downbeat/senseye/hardware/v2/stonyman_adc_board/schematic_and_layout_pdf/README

The source files for imager-adc.pdf (in the src directory) must be created
manually by printing to a PDF file from within the EAGLE tool.  The Makefile
merely uses PDFjam to combine those PDF files into a single documents.
