downbeat/senseye/software/v2/embedded/smartfusion_libero/senseye/designer/impl1/TOPLEVEL_iobank_report.txt

********************************************************************
                            I/O Bank Report
********************************************************************
  
Product: Designer
Release: v10.1 SP3
Version: 10.1.3.1
Date: Tue Oct 22 18:05:42 2013
Design Name: TOPLEVEL  Family: SmartFusion  Die: A2F500M3G  Package: 484 FBGA

I/O Function:

    Type                          | w/o register  | w/ register  | w/ DDR register
    ------------------------------|---------------|--------------|----------------
    Input I/O                     | 3             | 0            | 0
    Output I/O                    | 56            | 0            | 0
    Bidirectional I/O             | 16            | 0            | 0
    Differential Input I/O Pairs  | 0             | 0            | 0
    Differential Output I/O Pairs | 0             | 0            | 0

I/O Technology:

                                    |   Voltages    |             I/Os
    --------------------------------|-------|-------|-------|--------|--------------
    I/O Standard(s)                 | Vcci  | Vref  | Input | Output | Bidirectional
    --------------------------------|-------|-------|-------|--------|--------------
    LVTTL                           | 3.30v | N/A   | 3     | 56     | 16

I/O Bank Resource Usage:

          |   Voltages    | Single I/Os  | Diff I/O Pairs |        Vref I/Os
          |-------|-------|------|-------|-------|--------|------|-------|----------
          | Vcci  | Vref  | Used | Total | Used  | Total  | Used | Total | Vref Pins
    ------|-------|-------|------|-------|-------|--------|------|-------|----------
    Bank0 | 3.30v | N/A   | 32   | 50    | 0     | 25     | N/A  | N/A   | N/A
    Bank1 | 3.30v | N/A   | 10   | 36    | 0     | 18     | N/A  | N/A   | N/A
    Bank2 | MSS   | N/A   | N/A  | N/A   | N/A   | N/A    | N/A  | N/A   | N/A
    Bank3 | ANALOG| N/A   | N/A  | N/A   | N/A   | N/A    | N/A  | N/A   | N/A
    Bank4 | MSS   | N/A   | N/A  | N/A   | N/A   | N/A    | N/A  | N/A   | N/A
    Bank5 | 3.30v | N/A   | 33   | 42    | 0     | 21     | N/A  | N/A   | N/A

I/O Voltage Usage:

       Voltages    |     I/Os
    -------|-------|------|-------
     Vcci  | Vref  | Used | Total
    -------|-------|------|-------
     3.30v | N/A   | 75   | 128
