downbeat/senseye/software/v2/embedded/smartfusion_libero/senseye/designer/impl1/TOPLEVEL_maxdelay_timingviolations_report.txt

Timing Violation Report Max Delay Analysis

SmartTime Version v10.1 SP3
Actel Corporation - Actel Designer Software Release v10.1 SP3 (Version 10.1.3.1)
Copyright (c) 1989-2013
Date: Tue Oct 22 18:05:55 2013

Design: TOPLEVEL
Family: SmartFusion
Die: A2F500M3G
Package: 484 FBGA
Temperature: -40 25 100
Voltage: COM
Speed Grade: STD
Design State: Post-Layout
Data source: Silicon verified
Min Operating Condition: BEST
Max Operating Condition: WORST
Using Enhanced Min Delay Analysis
Scenario for Timing Analysis: Primary

No Path
