downbeat/senseye/hardware/v2/stonyman_adc_board/wirebonding_document/centeye/stonyman-die.png

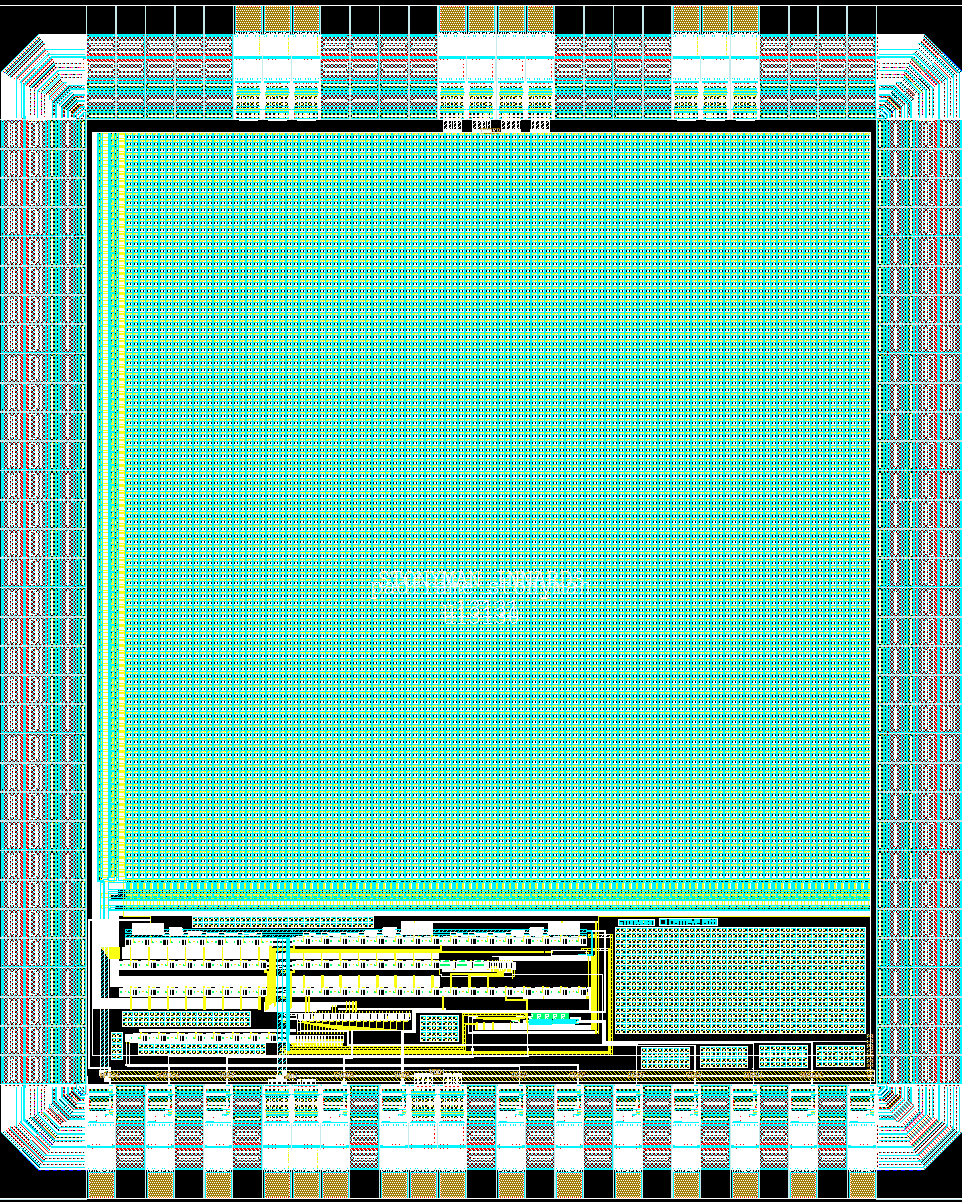
hardware/v2/stonyman_adc_board/wirebonding_document/centeye/stonyman-die.png
