downbeat/senseye/hardware/v2/stonyman_adc_board/wirebonding_document/src/senseye-imager-adc.png

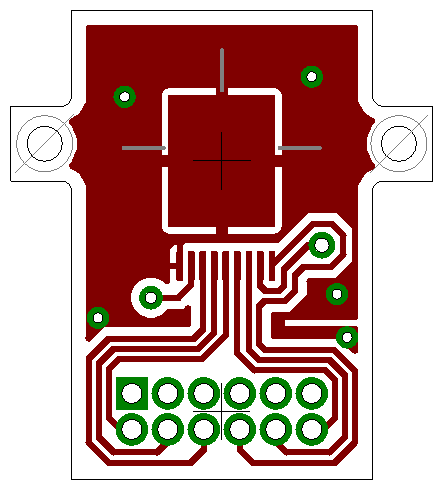
hardware/v2/stonyman_adc_board/wirebonding_document/src/senseye-imager-adc.png
