downbeat/senseye/hardware/v2/stonyman_adc_board/eagle_pcb/imager-adc_bom.xlsx

Part | Value | Package | DIGIKEY | Description
C1 | 1nF | C0603 | 1276-1916-2-ND | CAPACITOR, European symbol
C2 | 0.1uF | C0603 | 1276-1012-2-ND | CAPACITOR, European symbol
C3 | 0.1uF | C0603 | 1276-1012-2-ND | CAPACITOR, European symbol
C4 | 1uF | C0603 | 1276-1243-2-ND | CAPACITOR, European symbol
C5 | OPTIONAL: 10pF-1nF | C0603 | 1276-1187-6-ND | CAPACITOR, European symbol
J1 | HEADER_12PIN2X6_NOSILK | HEADER2X6/0.05IN_NO_SILK | S9015E-06-ND
R1 | 0 / UNPOP | R0603 | 1276-3510-6-ND | RESISTOR, American symbol
U1 | STONYMANDEFAULT_LENS_MOUNT | STONYMAN_DEFAULT_LENS |  | Centeye Stonyman imager chip
U2 | TI_ADCXX1S101 | SOT23-6 | ADC121S101CIMF/NOPBDKR-ND | Texas Instruments ADCXX1S101 (ADC081S101, ADC101S101, ADC121S101) Single Channel, 0.5 to 1.0 Msps, 8-bit, 10-bit and 12-bit A/D Converters
