downbeat/senseye/hardware/v1/teensy-shield/main.dxf

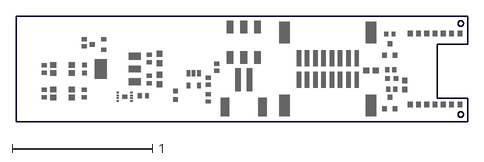
[picture p4: CAD file, 2012-11-15, an earlier design]
hardware/v1/teensy-shield/main.dxf
3.23 x 0.75
