downbeat/senseye/(list of files, cad)

Other CAD files:
software/v2/embedded/smartfusion_libero/senseye/component/Actel/DirectCore/CoreAHBLite/3.1.102/mti/user_vlog/COREAHBLITE_LIB/@b@f@m_@a@h@b@l/verilog.psm
software/v2/embedded/smartfusion_libero/senseye/component/Actel/DirectCore/CoreAHBLite/3.1.102/mti/user_vlog/COREAHBLITE_LIB/@b@f@m_@a@h@b@s@l@a@v@e/verilog.psm
software/v2/embedded/smartfusion_libero/senseye/component/Actel/DirectCore/CoreAHBLite/3.1.102/mti/user_vlog/COREAHBLITE_LIB/@b@f@m_@a@h@b@s@l@a@v@e@e@x@t/verilog.psm
software/v2/embedded/smartfusion_libero/senseye/component/Actel/DirectCore/CoreAHBLite/3.1.102/mti/user_vlog/COREAHBLITE_LIB/@b@f@m_@m@a@i@n/verilog.psm
software/v2/embedded/smartfusion_libero/senseye/component/Actel/DirectCore/CoreAPB3/3.0.103/mti/user_vlog/COREAPB3_LIB/@b@f@m@a1l1@o@i@i/verilog.psm
software/v2/embedded/smartfusion_libero/senseye/component/Actel/DirectCore/CoreAPB3/3.0.103/mti/user_vlog/COREAPB3_LIB/@b@f@m_@a@p@b/verilog.psm
software/v2/embedded/smartfusion_libero/senseye/component/Actel/DirectCore/CoreAPB3/3.0.103/mti/user_vlog/COREAPB3_LIB/@b@f@m_@a@p@b@s@l@a@v@e/verilog.psm
software/v2/embedded/smartfusion_libero/senseye/component/Actel/DirectCore/CoreAPB3/3.0.103/mti/user_vlog/COREAPB3_LIB/@b@f@m_@a@p@b@s@l@a@v@e@e@x@t/verilog.psm
software/v2/embedded/smartfusion_libero/senseye/component/Actel/DirectCore/CoreAPB3/3.0.103/mti/user_vlog/COREAPB3_LIB/@b@f@m_@m@a@i@n/verilog.psm
software/v2/embedded/smartfusion_libero/senseye/component/Actel/SmartFusionMSS/MSS/2.2.101/mti/user_verilog/MSS_BFM_LIB/@addr@dec@m0/verilog.psm
software/v2/embedded/smartfusion_libero/senseye/component/Actel/SmartFusionMSS/MSS/2.2.101/mti/user_verilog/MSS_BFM_LIB/@addr@dec@m1/verilog.psm
software/v2/embedded/smartfusion_libero/senseye/component/Actel/SmartFusionMSS/MSS/2.2.101/mti/user_verilog/MSS_BFM_LIB/@addr@dec@m2/verilog.psm
software/v2/embedded/smartfusion_libero/senseye/component/Actel/SmartFusionMSS/MSS/2.2.101/mti/user_verilog/MSS_BFM_LIB/@addr@dec@m3/verilog.psm
software/v2/embedded/smartfusion_libero/senseye/component/Actel/SmartFusionMSS/MSS/2.2.101/mti/user_verilog/MSS_BFM_LIB/@addr@dec@m4/verilog.psm
software/v2/embedded/smartfusion_libero/senseye/component/Actel/SmartFusionMSS/MSS/2.2.101/mti/user_verilog/MSS_BFM_LIB/@ahb@client_@h@m/verilog.psm
software/v2/embedded/smartfusion_libero/senseye/component/Actel/SmartFusionMSS/MSS/2.2.101/mti/user_verilog/MSS_BFM_LIB/@ahb@wrapper_@f@m/verilog.psm
software/v2/embedded/smartfusion_libero/senseye/component/Actel/SmartFusionMSS/MSS/2.2.101/mti/user_verilog/MSS_BFM_LIB/@ahb@wrapper_@h@m/verilog.psm
software/v2/embedded/smartfusion_libero/senseye/component/Actel/SmartFusionMSS/MSS/2.2.101/mti/user_verilog/MSS_BFM_LIB/@apb@client_@h@m/verilog.psm
software/v2/embedded/smartfusion_libero/senseye/component/Actel/SmartFusionMSS/MSS/2.2.101/mti/user_verilog/MSS_BFM_LIB/@apb@wrapper_@f@m/verilog.psm
software/v2/embedded/smartfusion_libero/senseye/component/Actel/SmartFusionMSS/MSS/2.2.101/mti/user_verilog/MSS_BFM_LIB/@b@f@m_@m@a@i@n/verilog.psm
software/v2/embedded/smartfusion_libero/senseye/component/Actel/SmartFusionMSS/MSS/2.2.101/mti/user_verilog/MSS_BFM_LIB/@c@m@master0@stage/verilog.psm
software/v2/embedded/smartfusion_libero/senseye/component/Actel/SmartFusionMSS/MSS/2.2.101/mti/user_verilog/MSS_BFM_LIB/@c@m@master1@stage/verilog.psm
software/v2/embedded/smartfusion_libero/senseye/component/Actel/SmartFusionMSS/MSS/2.2.101/mti/user_verilog/MSS_BFM_LIB/@c@m@master2@stage/verilog.psm
software/v2/embedded/smartfusion_libero/senseye/component/Actel/SmartFusionMSS/MSS/2.2.101/mti/user_verilog/MSS_BFM_LIB/@c@m@master3@stage/verilog.psm
software/v2/embedded/smartfusion_libero/senseye/component/Actel/SmartFusionMSS/MSS/2.2.101/mti/user_verilog/MSS_BFM_LIB/@c@m@master4@stage/verilog.psm
software/v2/embedded/smartfusion_libero/senseye/component/Actel/SmartFusionMSS/MSS/2.2.101/mti/user_verilog/MSS_BFM_LIB/@c@m@slave@stage/verilog.psm
software/v2/embedded/smartfusion_libero/senseye/component/Actel/SmartFusionMSS/MSS/2.2.101/mti/user_verilog/MSS_BFM_LIB/@client@addr@data_@f@m/verilog.psm
software/v2/embedded/smartfusion_libero/senseye/component/Actel/SmartFusionMSS/MSS/2.2.101/mti/user_verilog/MSS_BFM_LIB/@client@addr@data_@h@m/verilog.psm
software/v2/embedded/smartfusion_libero/senseye/component/Actel/SmartFusionMSS/MSS/2.2.101/mti/user_verilog/MSS_BFM_LIB/@client_@f@m/verilog.psm
software/v2/embedded/smartfusion_libero/senseye/component/Actel/SmartFusionMSS/MSS/2.2.101/mti/user_verilog/MSS_BFM_LIB/@d@s@s@a@b/verilog.psm
software/v2/embedded/smartfusion_libero/senseye/component/Actel/SmartFusionMSS/MSS/2.2.101/mti/user_verilog/MSS_BFM_LIB/@default@slave@s@m/verilog.psm
software/v2/embedded/smartfusion_libero/senseye/component/Actel/SmartFusionMSS/MSS/2.2.101/mti/user_verilog/MSS_BFM_LIB/@f2@a@b/verilog.psm
software/v2/embedded/smartfusion_libero/senseye/component/Actel/SmartFusionMSS/MSS/2.2.101/mti/user_verilog/MSS_BFM_LIB/@f2@d@s@s_@a@c@e/verilog.psm
software/v2/embedded/smartfusion_libero/senseye/component/Actel/SmartFusionMSS/MSS/2.2.101/mti/user_verilog/MSS_BFM_LIB/@f2@d@s@s_@a@c@e_@m@i@s@c/verilog.psm
software/v2/embedded/smartfusion_libero/senseye/component/Actel/SmartFusionMSS/MSS/2.2.101/mti/user_verilog/MSS_BFM_LIB/@f2@d@s@s_@a@c@e_@m@i@s@c_@a@p@b3/verilog.psm
software/v2/embedded/smartfusion_libero/senseye/component/Actel/SmartFusionMSS/MSS/2.2.101/mti/user_verilog/MSS_BFM_LIB/@f2@d@s@s_@a@c@e_@m@i@s@c_@f@d@e@t/verilog.psm
software/v2/embedded/smartfusion_libero/senseye/component/Actel/SmartFusionMSS/MSS/2.2.101/mti/user_verilog/MSS_BFM_LIB/@f2@d@s@s_@a@c@e_@m@i@s@c_@f@d@e@t12/verilog.psm
software/v2/embedded/smartfusion_libero/senseye/component/Actel/SmartFusionMSS/MSS/2.2.101/mti/user_verilog/MSS_BFM_LIB/@f2@d@s@s_@a@c@e_@m@i@s@c_@i@n@t_@l@o@g@i@c/verilog.psm
software/v2/embedded/smartfusion_libero/senseye/component/Actel/SmartFusionMSS/MSS/2.2.101/mti/user_verilog/MSS_BFM_LIB/@f2@d@s@s_@a@c@e_@m@i@s@c_@p@d@m@a/verilog.psm
software/v2/embedded/smartfusion_libero/senseye/component/Actel/SmartFusionMSS/MSS/2.2.101/mti/user_verilog/MSS_BFM_LIB/@f2@d@s@s_@a@c@e_@m@i@s@c_@r@d@e@t/verilog.psm
software/v2/embedded/smartfusion_libero/senseye/component/Actel/SmartFusionMSS/MSS/2.2.101/mti/user_verilog/MSS_BFM_LIB/@f2@d@s@s_@a@c@e_@m@i@s@c_@r@d@e@t12/verilog.psm
software/v2/embedded/smartfusion_libero/senseye/component/Actel/SmartFusionMSS/MSS/2.2.101/mti/user_verilog/MSS_BFM_LIB/@f2@d@s@s_@a@c@e_@m@i@s@c_@r@d@e@t32/verilog.psm
software/v2/embedded/smartfusion_libero/senseye/component/Actel/SmartFusionMSS/MSS/2.2.101/mti/user_verilog/MSS_BFM_LIB/@f2@d@s@s_@a@c@e_@m@i@s@c_@r@d@m@u@x/verilog.psm
software/v2/embedded/smartfusion_libero/senseye/component/Actel/SmartFusionMSS/MSS/2.2.101/mti/user_verilog/MSS_BFM_LIB/@f2@d@s@s_@a@c@e_@m@i@s@c_@s@t@i@c@k@y@f@l@a@g/verilog.psm
software/v2/embedded/smartfusion_libero/senseye/component/Actel/SmartFusionMSS/MSS/2.2.101/mti/user_verilog/MSS_BFM_LIB/@f2@d@s@s_@a@c@e_@m@i@s@c_@s@t@i@c@k@y@f@l@a@g21/verilog.psm
software/v2/embedded/smartfusion_libero/senseye/component/Actel/SmartFusionMSS/MSS/2.2.101/mti/user_verilog/MSS_BFM_LIB/@f2@d@s@s_@a@c@e_@m@i@s@c_@s@t@i@c@k@y@f@l@a@g24/verilog.psm
software/v2/embedded/smartfusion_libero/senseye/component/Actel/SmartFusionMSS/MSS/2.2.101/mti/user_verilog/MSS_BFM_LIB/@f2@d@s@s_@a@c@e_@m@i@s@c_@s@t@i@c@k@y@f@l@a@g32/verilog.psm
software/v2/embedded/smartfusion_libero/senseye/component/Actel/SmartFusionMSS/MSS/2.2.101/mti/user_verilog/MSS_BFM_LIB/@f2@d@s@s_@a@c@e_@m@i@s@c_@s@t@i@c@k@y@f@l@a@g9/verilog.psm
software/v2/embedded/smartfusion_libero/senseye/component/Actel/SmartFusionMSS/MSS/2.2.101/mti/user_verilog/MSS_BFM_LIB/@f2@d@s@s_@a@c@e_@m@i@s@c_@s@y@n@c/verilog.psm
software/v2/embedded/smartfusion_libero/senseye/component/Actel/SmartFusionMSS/MSS/2.2.101/mti/user_verilog/MSS_BFM_LIB/@f2@d@s@s_@a@c@e_@m@i@s@c_@s@y@n@c12/verilog.psm
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
