downbeat/senseye/hardware/v2/stonyman_adc_board/schematic_and_layout_pdf/imager-adc.pdf

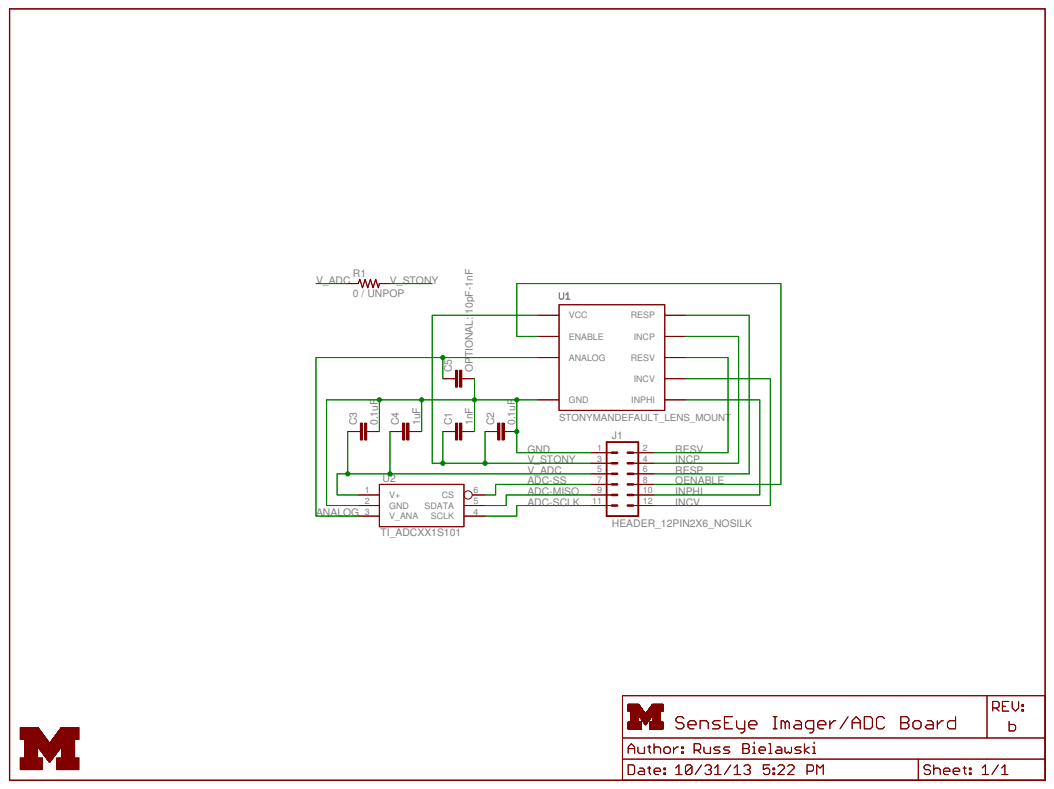
[picture p7: page 1]

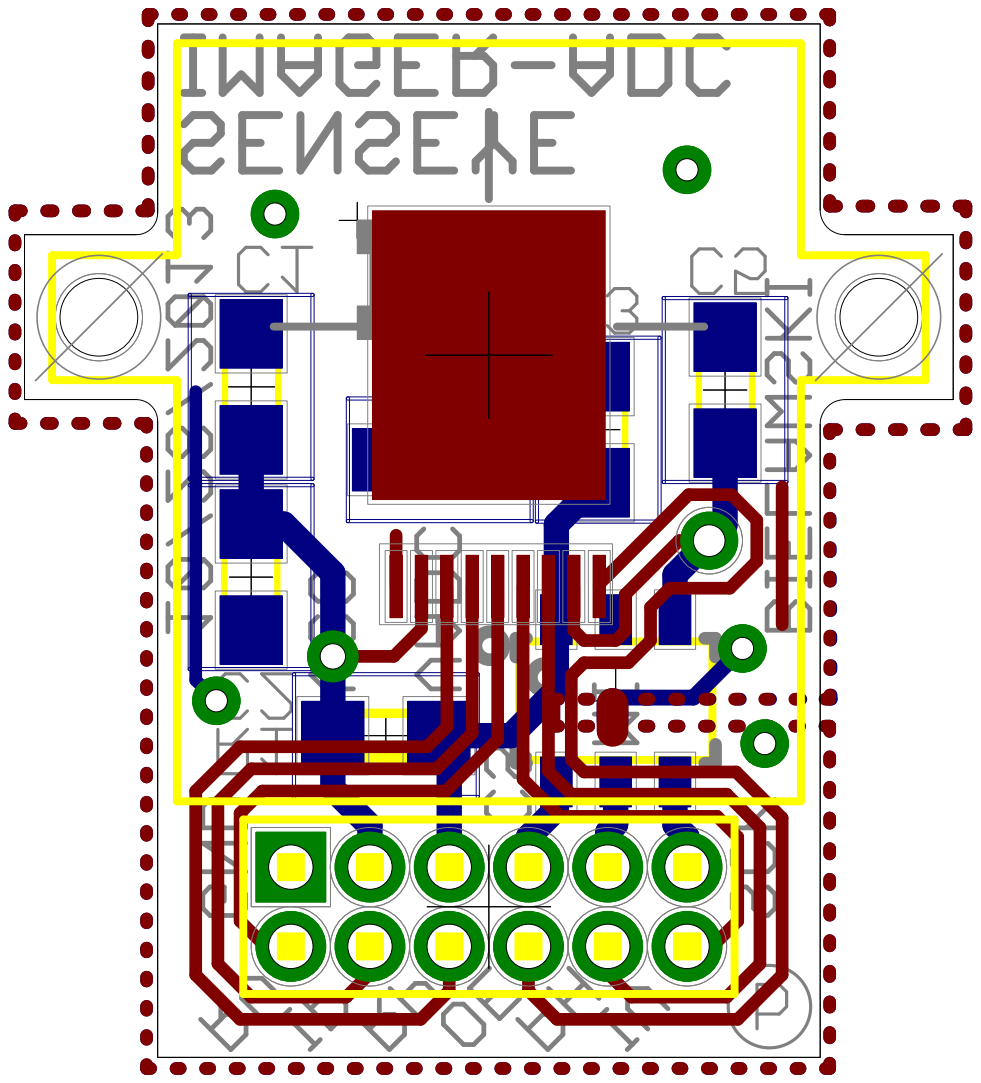
[picture p8: page 2]

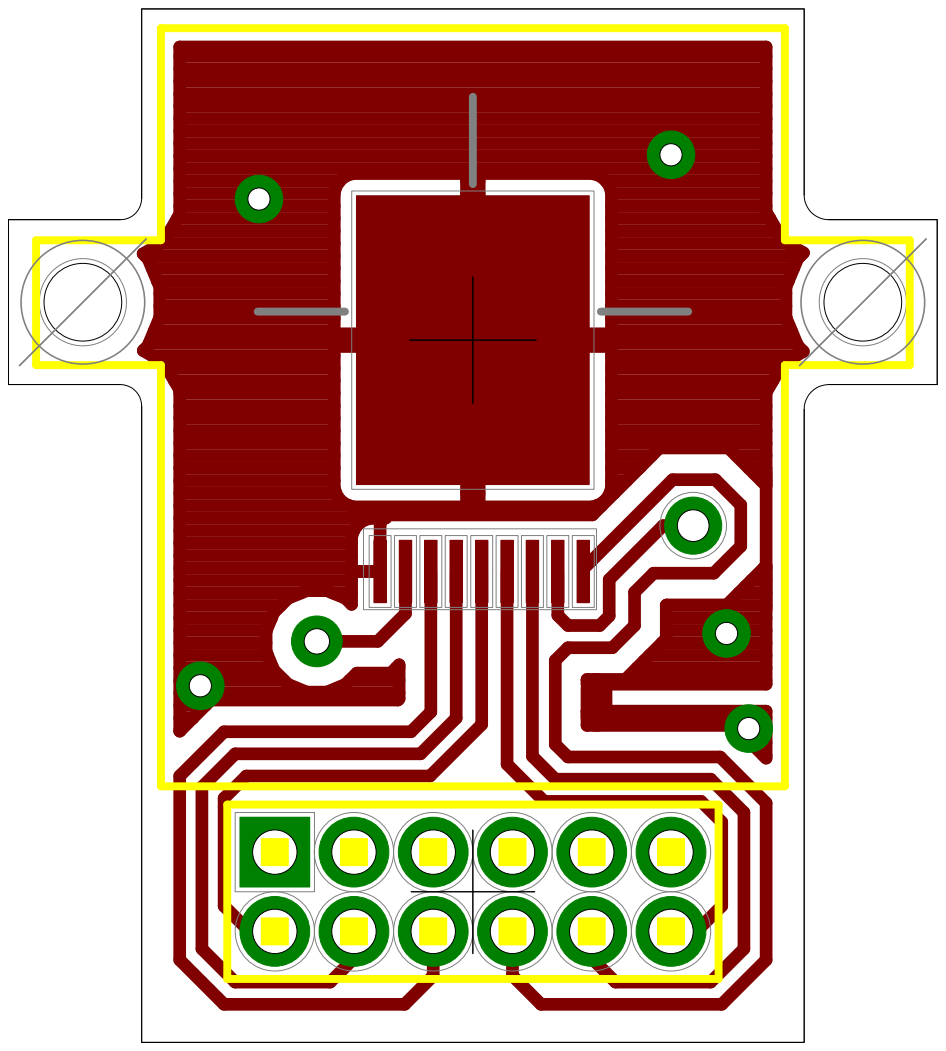
[picture p9: page 3]

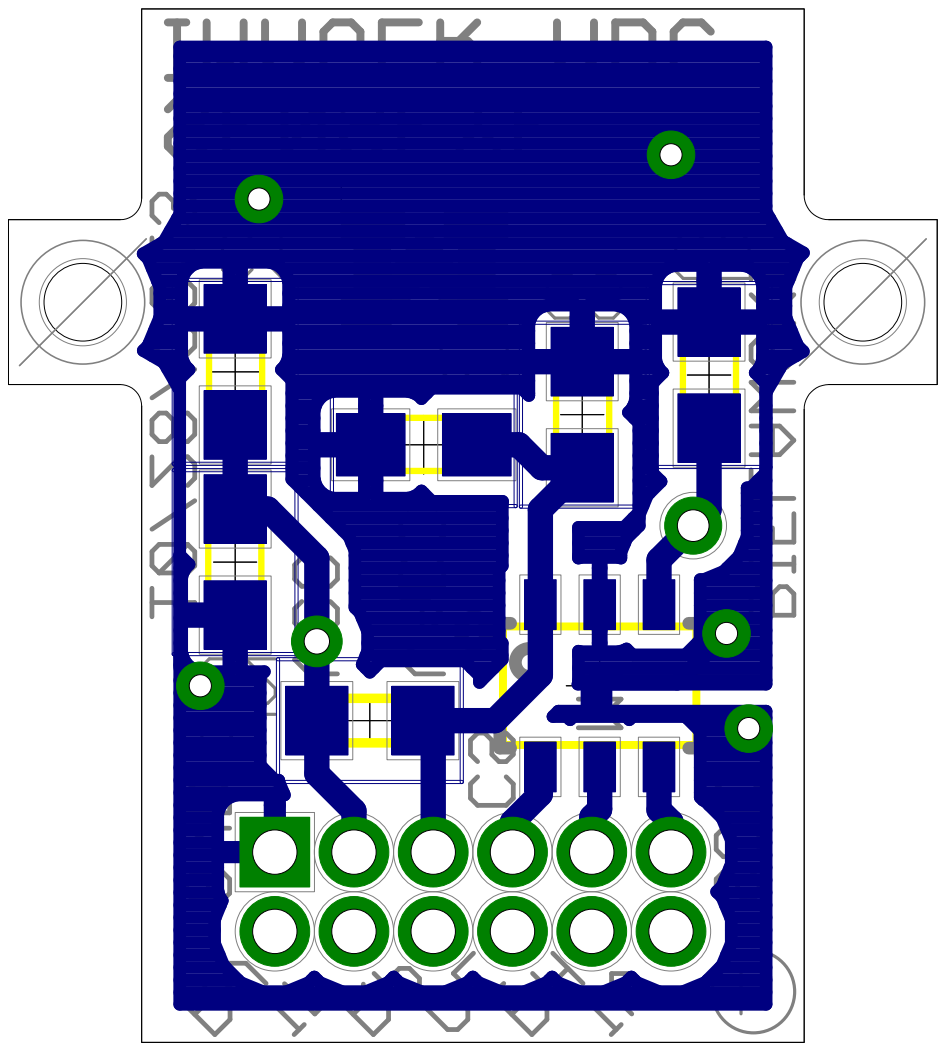
[picture p10: page 4]

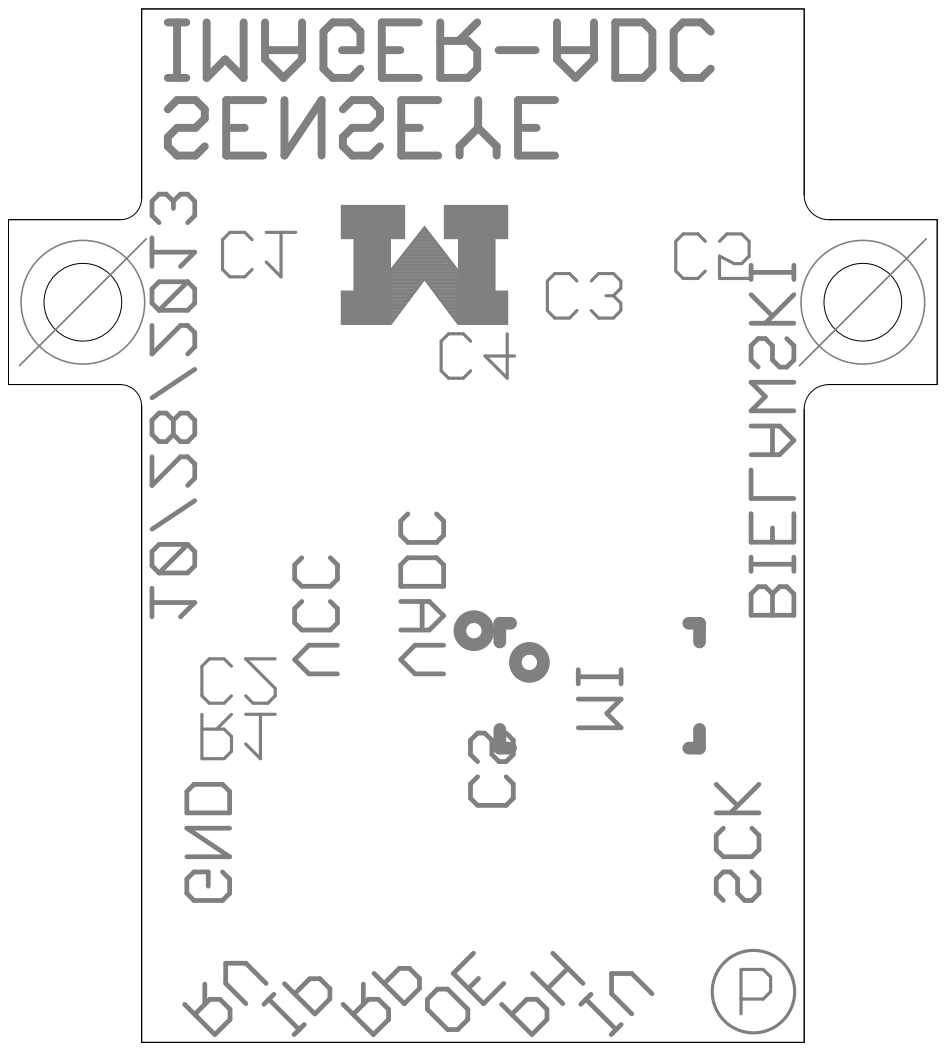
[picture p11: page 5]
