downbeat/senseye/hardware/v2/stonyman_adc_board/schematic_and_layout_pdf/src/imager-adc_board.pdf

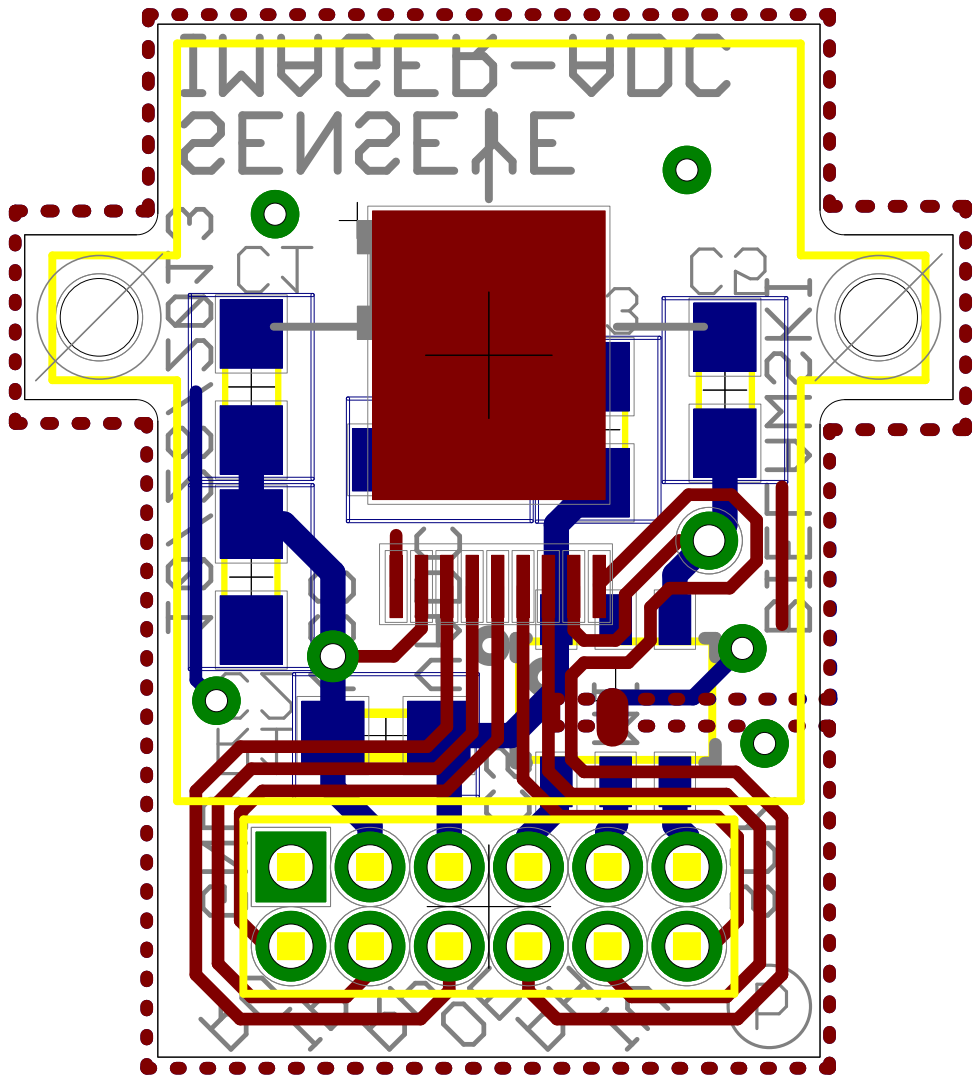
[picture p12: page 1]
