downbeat/senseye/hardware/v2/stonyman_adc_board/schematic_and_layout_pdf/src/imager-adc_bottom.pdf

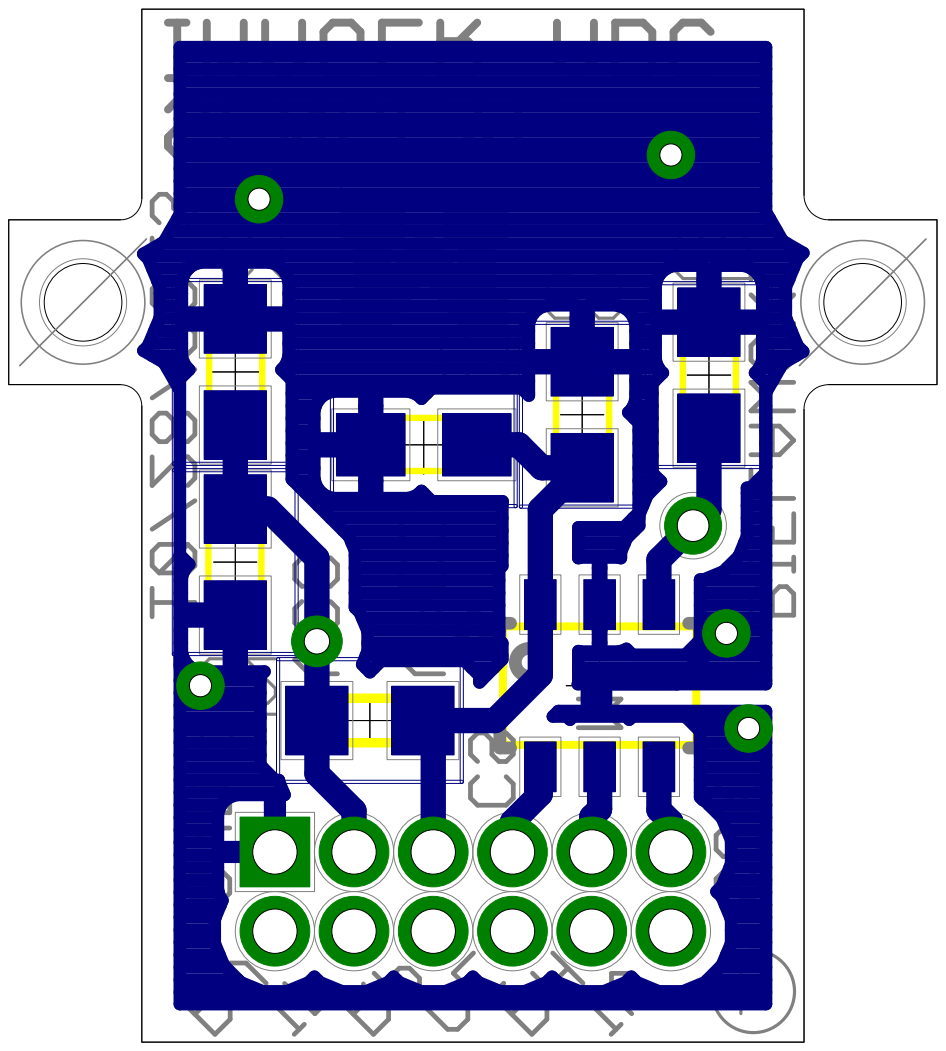
[picture p13: page 1]
