downbeat/senseye/hardware/v2/stonyman_adc_board/schematic_and_layout_pdf/src/imager-adc_schematic.pdf

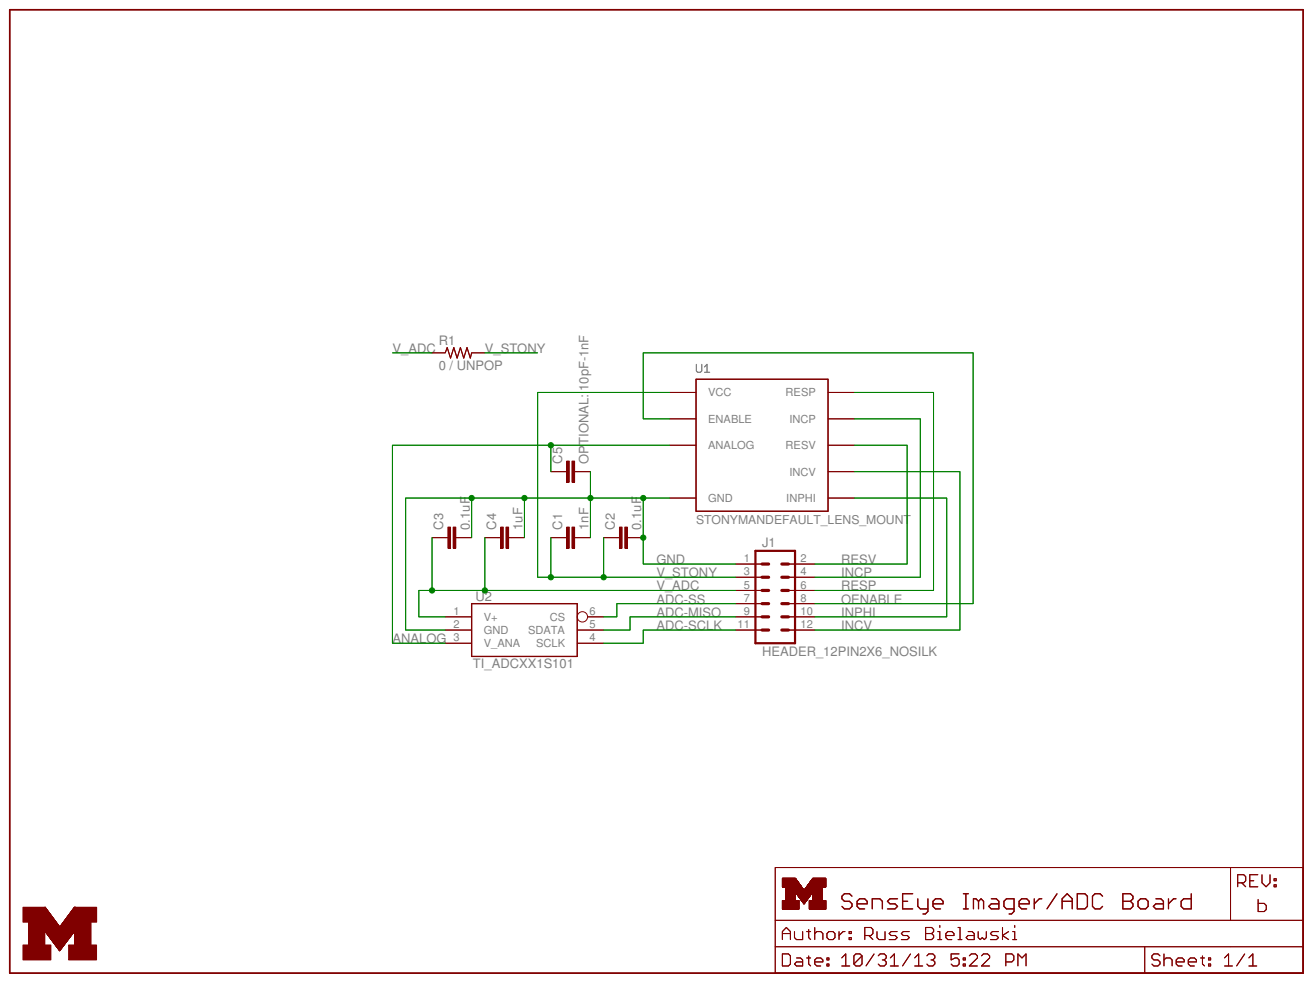
[picture p14: page 1]
