downbeat/senseye/hardware/v2/stonyman_adc_board/schematic_and_layout_pdf/src/imager-adc_silk.pdf

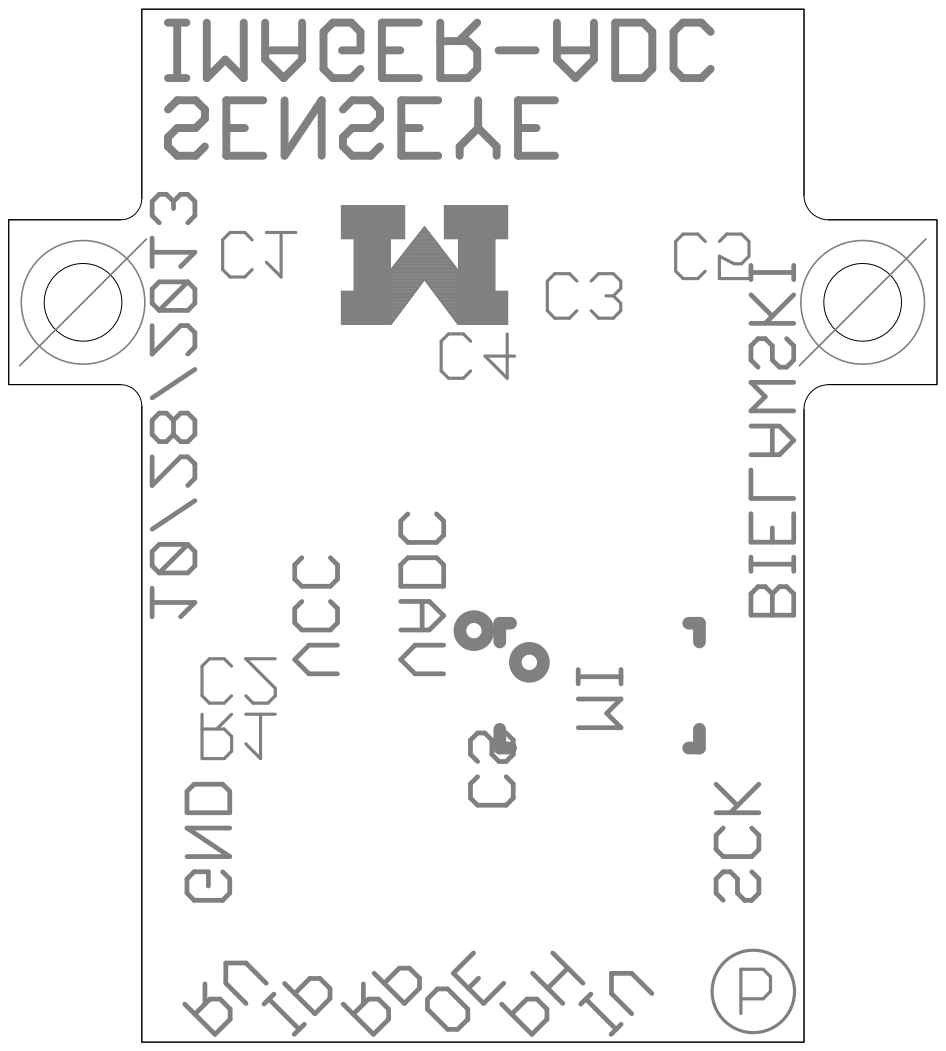
[picture p15: page 1]
