downbeat/senseye/hardware/v2/stonyman_adc_board/schematic_and_layout_pdf/src/imager-adc_top.pdf

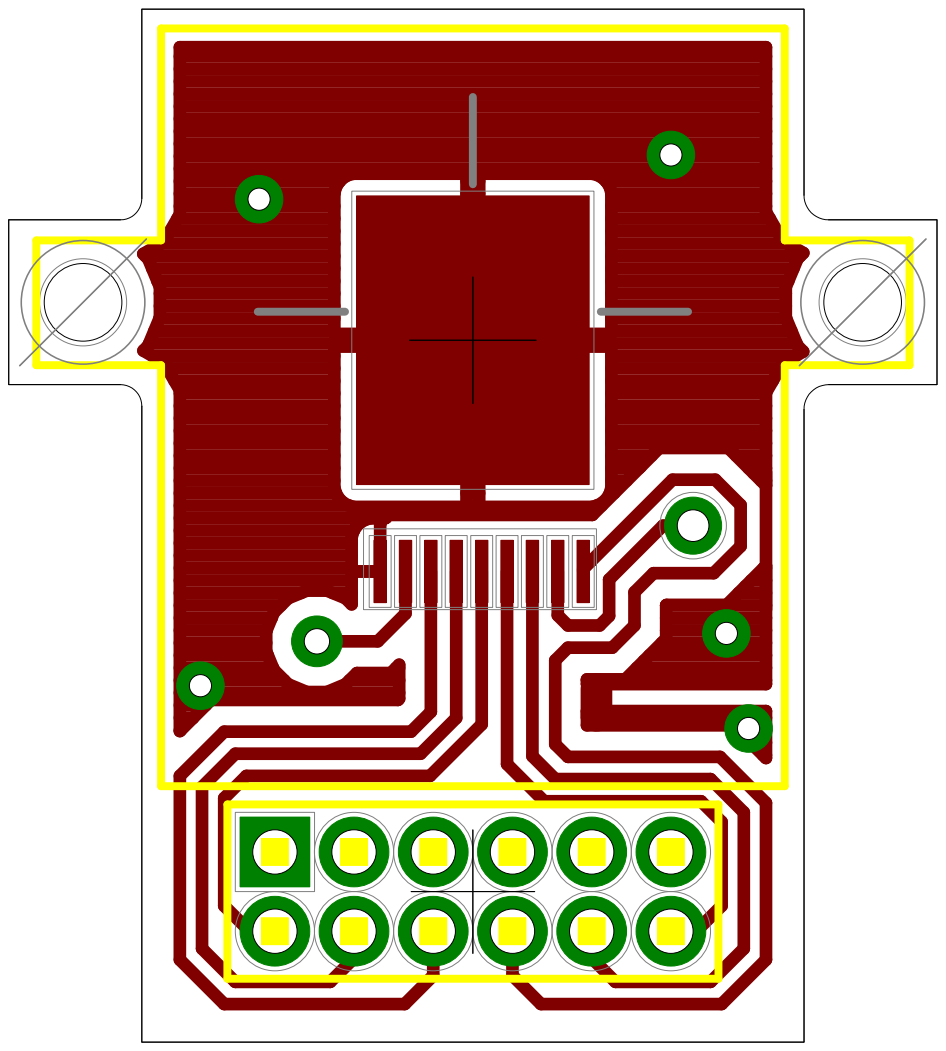
[picture p16: page 1]
