downbeat/senseye/hardware/v1/teensy-shield/main.brd

## EAGLE design hardware/v1/teensy-shield/main.brd (2013-05-09, an earlier design)

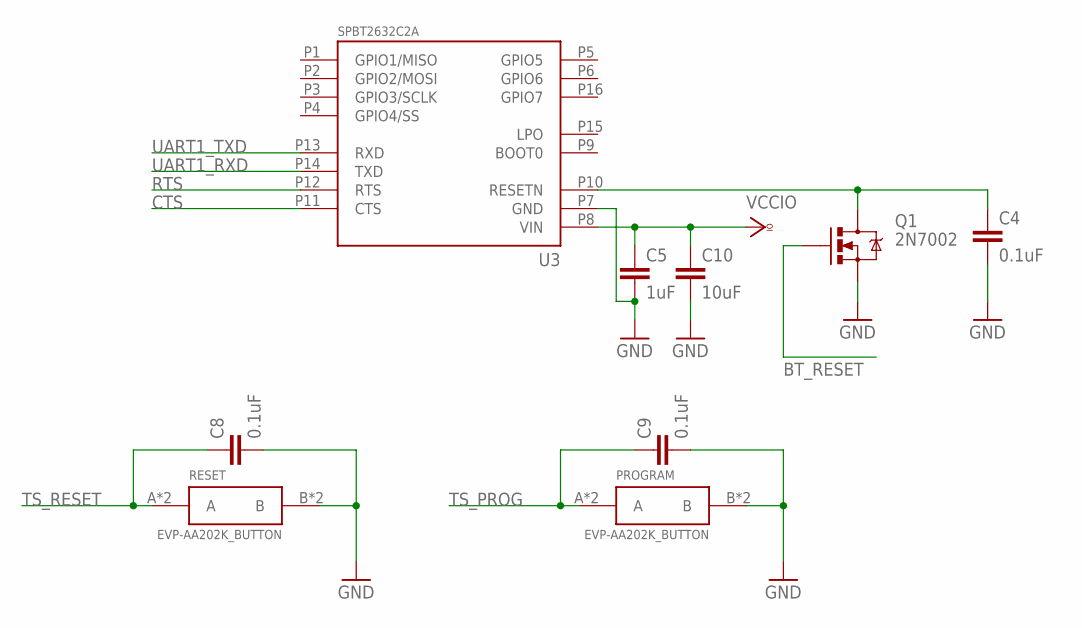
[picture p20: schematic main.sch, sheet 1]

Parts:
C4: 0.1uF; C0402
C5: 1uF; C0402
C8, C9: 0.1uF; C0603
C10: 10uF; C0603@1
PROGRAM: EVP-AA202K_BUTTON; EVP-AA202K_4PIN
Q1: 2N7002; SOT23-3
RESET: EVP-AA202K_BUTTON; EVP-AA202K_4PIN
U3: SPBT2632C2A; SPBT2632C2A_16PIN_SMD

Connections:
BT_RESET: Q1.1 (G); also elsewhere on the board
CTS: U3.P11 (CTS); also elsewhere on the board
GND: C4.2, C5.2, C8.2, C9.2, C10.2, PROGRAM.B, PROGRAM.B' (B), Q1.2 (S), RESET.B, RESET.B' (B), U3.P7 (GND); also elsewhere on the board
unnamed: C4.1, Q1.3 (D), U3.P10 (RESETN)
RTS: U3.P12 (RTS); also elsewhere on the board
TS_PROG: C9.1, PROGRAM.A, PROGRAM.A' (A); also elsewhere on the board
TS_RESET: C8.1, RESET.A, RESET.A' (A); also elsewhere on the board
UART1_RXD: U3.P14 (TXD); also elsewhere on the board
UART1_TXD: U3.P13 (RXD); also elsewhere on the board
VCCIO: C5.1, C10.1, U3.P8 (VIN); also elsewhere on the board

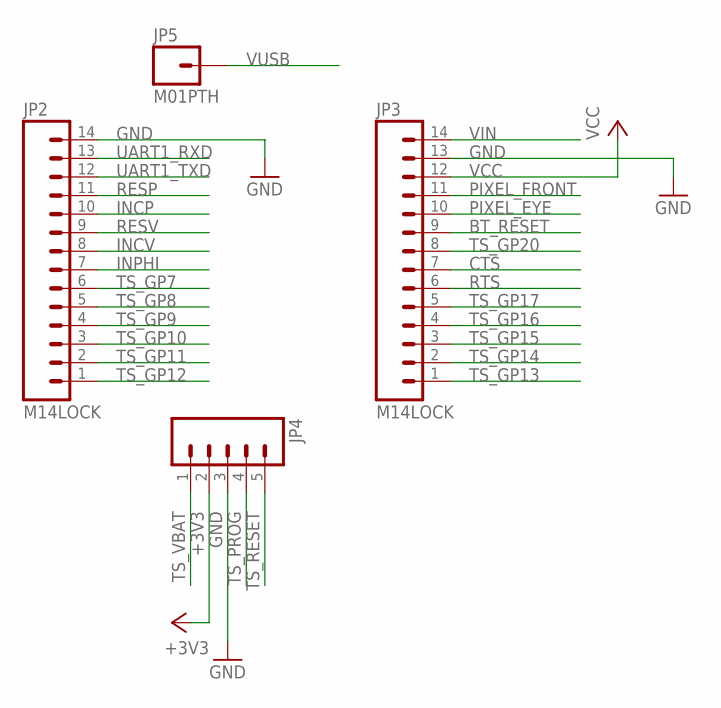
[picture p21: schematic main.sch, sheet 2]

Parts:
JP2, JP3: M14LOCK; 1X14_LOCK
JP4: M05LOCK; 1X05_LOCK
JP5: M01PTH; 1X01

Connections:
+3V3: JP4.2
BT_RESET: JP3.9; also elsewhere on the board
CTS: JP3.7; also elsewhere on the board
GND: JP2.14, JP3.13, JP4.3; also elsewhere on the board
INCP: JP2.10
INCV: JP2.8
INPHI: JP2.7
PIXEL_EYE: JP3.10
PIXEL_FRONT: JP3.11
RESP: JP2.11
RESV: JP2.9
RTS: JP3.6; also elsewhere on the board
TS_GP7: JP2.6
TS_GP8: JP2.5
TS_GP9: JP2.4
TS_GP10: JP2.3
TS_GP11: JP2.2
TS_GP12: JP2.1
TS_GP13: JP3.1
TS_GP14: JP3.2
TS_GP15: JP3.3
TS_GP16: JP3.4
TS_GP17: JP3.5
TS_GP20: JP3.8
TS_PROG: JP4.4; also elsewhere on the board
TS_RESET: JP4.5; also elsewhere on the board
TS_VBAT: JP4.1
UART1_RXD: JP2.13; also elsewhere on the board
UART1_TXD: JP2.12; also elsewhere on the board
VCC: JP3.12
VIN: JP3.14; also elsewhere on the board
VUSB: JP5.1; also elsewhere on the board

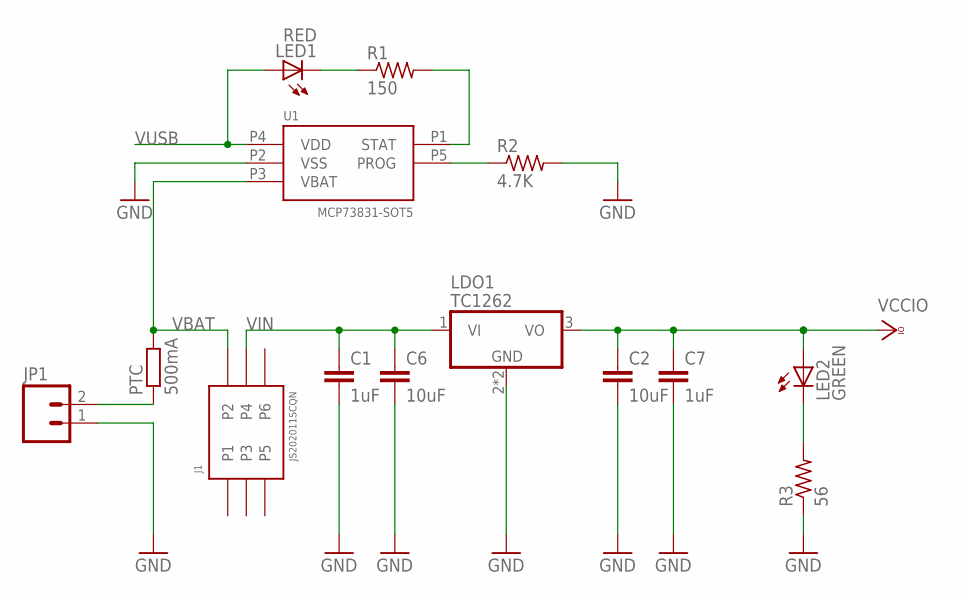
[picture p22: schematic main.sch, sheet 3]

Parts:
C1: 1uF; C0603
C2: 10uF; C0603
C6: 10uF; C0603@1
C7: 1uF; C0603@1
J1: JS202011SCQN; JS2020_6PIN_SMT
JP1: M02-JST-2MM-SMT; JST-2-SMD
LDO1: TC1262; SOT223
LED1: RED; CHIPLED_0603
LED2: GREEN; CHIPLED_0603
PTC: 500mA; R0402
R1: 150; R0402
R2: 4.7K; R0402
R3: 56; R0603
U1: MCP73831-SOT5; SOT23-5

Connections:
GND: C1.2, C2.2, C6.2, C7.2, JP1.1, LDO1.2 (GND), LDO1.4 (GND), R2.2, R3.1, U1.P2 (VSS); also elsewhere on the board
unnamed: LED1.C, R1.1
unnamed: R1.2, U1.P1 (STAT)
unnamed: R2.1, U1.P5 (PROG)
unnamed: JP1.2, PTC.1
unnamed: LED2.C, R3.2
VBAT: J1.P2, PTC.2, U1.P3 (VBAT)
VCCIO: C2.1, C7.1, LDO1.3 (VO), LED2.A; also elsewhere on the board
VIN: C1.1, C6.1, J1.P4, LDO1.1 (VI); also elsewhere on the board
VUSB: LED1.A, U1.P4 (VDD); also elsewhere on the board

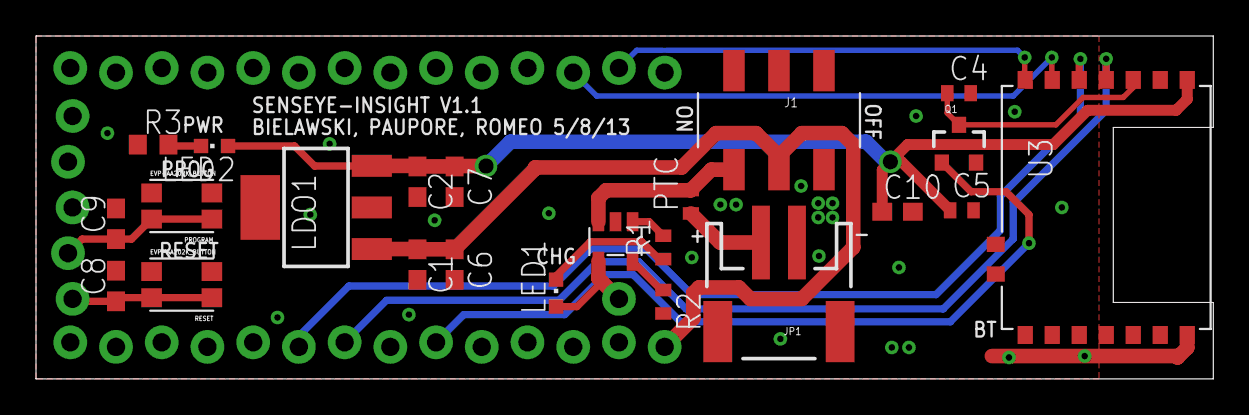
[picture p23: board main.brd from above]

Board: 2 copper layers, 65.4 x 19.1 mm, 27 parts (0 on the bottom side), 18 nets.
