downbeat/senseye/hardware/v1/teensy-shield/panel.brd

## EAGLE design hardware/v1/teensy-shield/panel.brd (2012-11-15, an earlier design)

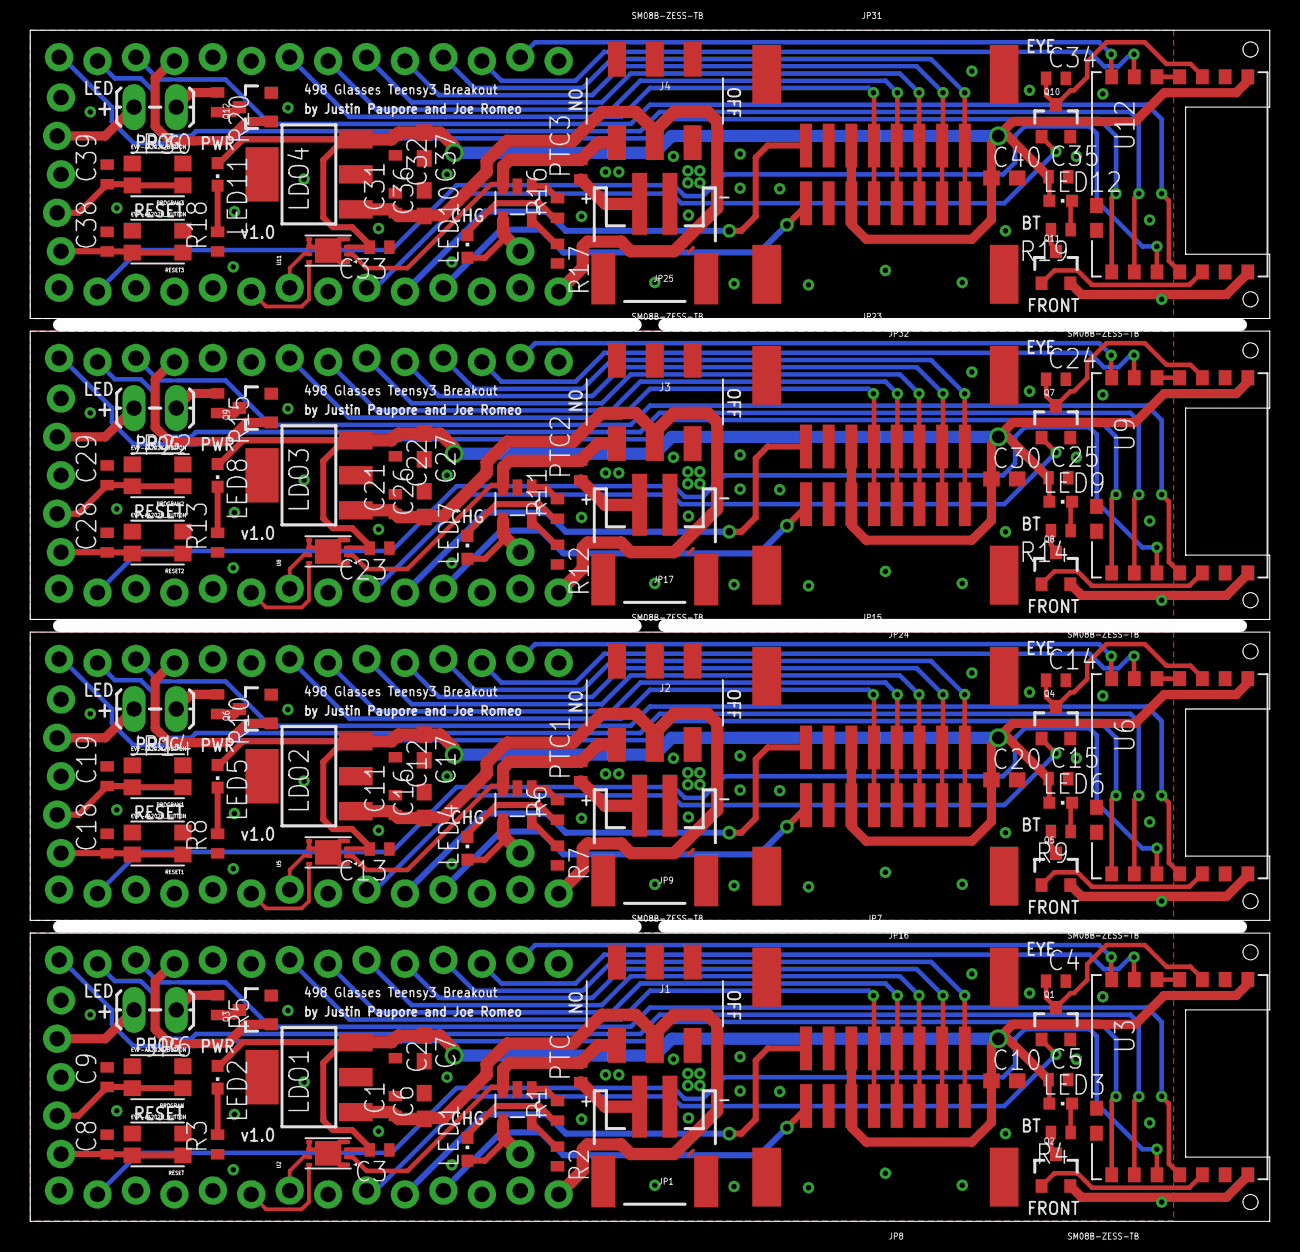
[picture p24: board panel.brd from above]

Board: 2 copper layers, 81.9 x 78.7 mm, 148 parts (0 on the bottom side), 148 nets.

Parts:
C1, C2, C3, C5, C11, C12, C13, C15, C21, C22, C23, C25, C31, C32, C33, C35: 1uF; C0402
C4, C8, C9, C14, C18, C19, C24, C28, C29, C34, C38, C39: 0.1uF; C0402
C6, C7, C10, C16, C17, C20, C26, C27, C30, C36, C37, C40: 10uF; C0603
J1, J2, J3, J4: JS202011SCQN; JS2020_6PIN_SMT
JP1, JP9, JP17, JP25: JST-2-SMD
JP2, JP3, JP10, JP11, JP18, JP19, JP26, JP27: M14LOCK; 1X14_LOCK
JP4, JP12, JP20, JP28: 1X05_LOCK
JP5, JP13, JP21, JP29: M01PTH; 1X01
JP6, JP14, JP22, JP30: LED; 1X02_LOCK_LONGPADS
JP7, JP8, JP15, JP16, JP23, JP24, JP31, JP32: SM08B-ZESS-TB; SM08B_8PIN_SMD
LDO1, LDO2, LDO3, LDO4: TC1262; SOT223
LED1, LED4, LED7, LED10: RED; CHIPLED_0603
LED2, LED5, LED8, LED11: GREEN; CHIPLED_0603
LED3, LED6, LED9, LED12: BLUE; CHIPLED_0603
PROGRAM, PROGRAM1, PROGRAM2, PROGRAM3: EVP-AA202K_BUTTON; EVP-AA202K_4PIN
PTC, PTC1, PTC2, PTC3: 500mA; R0402
Q1, Q2, Q3, Q4, Q5, Q6, Q7, Q8, Q9, Q10, Q11, Q12: 2N7002; SOT23-3
R1, R6, R11, R16: 150; R0402
R2, R7, R12, R17: 4.7K; R0402
R3, R4, R8, R9, R13, R14, R18, R19: 56; R0402
R5, R10, R15, R20: DNI; R0402
RESET, RESET1, RESET2, RESET3: EVP-AA202K_BUTTON; EVP-AA202K_4PIN
U1, U4, U7, U10: MCP73831-SOT5; SOT23-5
U2, U5, U8, U11: MAX17040-TDFN; TDFN_8PIN
U3, U6, U9, U12: SPBT2632C2A; SPBT2632C2A_16PIN_SMD

Connections:
+3V1: JP12.2, JP14.2
+3V2: JP20.2, JP22.2
+3V3: JP4.2, JP6.2
+3V4: JP28.2, JP30.2
BT_RESET: JP3.9, Q1.1
BT_RESET1: JP11.9, Q4.1
BT_RESET2: JP19.9, Q7.1
BT_RESET3: JP27.9, Q10.1
GND: C1.2, C2.2, C3.1, C4.2, C5.2, C6.2, C7.2, C8.2, C9.2, C10.2, JP1.1, JP2.14, JP3.13, JP4.3, JP7.P7, JP8.P2, LDO1.2, LDO1.4, PROGRAM.B, PROGRAM.B', Q1.2, Q2.2, Q3.2, R2.2, R3.1, RESET.B, RESET.B', U1.P2, U2.EP, U2.P1, U2.P4, U2.P5, U2.P6, U3.P7
GND1: C11.2, C12.2, C13.1, C14.2, C15.2, C16.2, C17.2, C18.2, C19.2, C20.2, JP9.1, JP10.14, JP11.13, JP12.3, JP15.P7, JP16.P2, LDO2.2, LDO2.4, PROGRAM1.B, PROGRAM1.B', Q4.2, Q5.2, Q6.2, R7.2, R8.1, RESET1.B, RESET1.B', U4.P2, U5.EP, U5.P1, U5.P4, U5.P5, U5.P6, U6.P7
GND2: C21.2, C22.2, C23.1, C24.2, C25.2, C26.2, C27.2, C28.2, C29.2, C30.2, JP17.1, JP18.14, JP19.13, JP20.3, JP23.P7, JP24.P2, LDO3.2, LDO3.4, PROGRAM2.B, PROGRAM2.B', Q7.2, Q8.2, Q9.2, R12.2, R13.1, RESET2.B, RESET2.B', U7.P2, U8.EP, U8.P1, U8.P4, U8.P5, U8.P6, U9.P7
GND3: C31.2, C32.2, C33.1, C34.2, C35.2, C36.2, C37.2, C38.2, C39.2, C40.2, JP25.1, JP26.14, JP27.13, JP28.3, JP31.P7, JP32.P2, LDO4.2, LDO4.4, PROGRAM3.B, PROGRAM3.B', Q10.2, Q11.2, Q12.2, R17.2, R18.1, RESET3.B, RESET3.B', U10.P2, U11.EP, U11.P1, U11.P4, U11.P5, U11.P6, U12.P7
I2C_SCL: JP3.7, U2.P7
I2C_SCL1: JP11.7, U5.P7
I2C_SCL2: JP19.7, U8.P7
I2C_SCL3: JP27.7, U11.P7
I2C_SDA: JP3.6, U2.P8
I2C_SDA1: JP11.6, U5.P8
I2C_SDA2: JP19.6, U8.P8
I2C_SDA3: JP27.6, U11.P8
INCP: JP2.10, JP7.P2, JP8.P7
INCP1: JP10.10, JP15.P2, JP16.P7
INCP2: JP18.10, JP23.P2, JP24.P7
INCP3: JP26.10, JP31.P2, JP32.P7
INCV: JP2.8, JP7.P4, JP8.P5
INCV1: JP10.8, JP15.P4, JP16.P5
INCV2: JP18.8, JP23.P4, JP24.P5
INCV3: JP26.8, JP31.P4, JP32.P5
INPHI: JP2.7, JP7.P5, JP8.P4
INPHI1: JP10.7, JP15.P5, JP16.P4
INPHI2: JP18.7, JP23.P5, JP24.P4
INPHI3: JP26.7, JP31.P5, JP32.P4
IR_LED: JP2.4, Q3.1
IR_LED1: JP10.4, Q6.1
IR_LED2: JP18.4, Q9.1
IR_LED3: JP26.4, Q12.1
unnamed: LED1.C, R1.1
unnamed: R1.2, U1.P1
unnamed: R2.1, U1.P5
unnamed: JP1.2, PTC.1
unnamed: LED2.C, R3.2
unnamed: U3.P11, U3.P12
unnamed: C4.1, Q1.3, U3.P10
unnamed: Q2.1, U3.P5
unnamed: LED3.C, R4.1
unnamed: Q2.3, R4.2
unnamed: JP6.1, R5.1
unnamed: Q3.3, R5.2
unnamed: U6.P11, U6.P12
unnamed: C14.1, Q4.3, U6.P10
unnamed: Q5.1, U6.P5
unnamed: LED6.C, R9.1
unnamed: Q5.3, R9.2
unnamed: JP14.1, R10.1
unnamed: Q6.3, R10.2
unnamed: R6.2, U4.P1
unnamed: R7.1, U4.P5
unnamed: JP9.2, PTC1.1
unnamed: LED5.C, R8.2
unnamed: LED4.C, R6.1
unnamed: U9.P11, U9.P12
unnamed: C24.1, Q7.3, U9.P10
unnamed: Q8.1, U9.P5
unnamed: LED9.C, R14.1
unnamed: Q8.3, R14.2
unnamed: JP22.1, R15.1
unnamed: Q9.3, R15.2
unnamed: R11.2, U7.P1
unnamed: R12.1, U7.P5
unnamed: JP17.2, PTC2.1
unnamed: LED8.C, R13.2
unnamed: LED7.C, R11.1
unnamed: U12.P11, U12.P12
unnamed: C34.1, Q10.3, U12.P10
unnamed: Q11.1, U12.P5
unnamed: LED12.C, R19.1
unnamed: Q11.3, R19.2
unnamed: JP30.1, R20.1
unnamed: Q12.3, R20.2
unnamed: R16.2, U10.P1
unnamed: R17.1, U10.P5
unnamed: JP25.2, PTC3.1
unnamed: LED11.C, R18.2
unnamed: LED10.C, R16.1
PIXEL_EYE: JP3.10, JP7.P8
PIXEL_EYE1: JP11.10, JP15.P8
PIXEL_EYE2: JP19.10, JP23.P8
PIXEL_EYE3: JP27.10, JP31.P8
PIXEL_FRONT: JP3.11, JP8.P1
PIXEL_FRONT1: JP11.11, JP16.P1
PIXEL_FRONT2: JP19.11, JP24.P1
PIXEL_FRONT3: JP27.11, JP32.P1
RESP: JP2.11, JP7.P1, JP8.P8
RESP1: JP10.11, JP15.P1, JP16.P8
RESP2: JP18.11, JP23.P1, JP24.P8
RESP3: JP26.11, JP31.P1, JP32.P8
RESV: JP2.9, JP7.P3, JP8.P6
RESV1: JP10.9, JP15.P3, JP16.P6
RESV2: JP18.9, JP23.P3, JP24.P6
RESV3: JP26.9, JP31.P3, JP32.P6
SPI_CS: JP2.3, U3.P4
SPI_CS1: JP10.3, U6.P4
SPI_CS2: JP18.3, U9.P4
SPI_CS3: JP26.3, U12.P4
SPI_MISO: JP2.1, U3.P1
SPI_MISO1: JP10.1, U6.P1
SPI_MISO2: JP18.1, U9.P1
SPI_MISO3: JP26.1, U12.P1
SPI_MOSI: JP2.2, U3.P2
SPI_MOSI1: JP10.2, U6.P2
SPI_MOSI2: JP18.2, U9.P2
SPI_MOSI3: JP26.2, U12.P2
SPI_SCK: JP3.2, U3.P3
SPI_SCK1: JP11.2, U6.P3
SPI_SCK2: JP19.2, U9.P3
SPI_SCK3: JP27.2, U12.P3
TS_PROG: C9.1, JP4.4, PROGRAM.A, PROGRAM.A'
TS_PROG1: C19.1, JP12.4, PROGRAM1.A, PROGRAM1.A'
TS_PROG2: C29.1, JP20.4, PROGRAM2.A, PROGRAM2.A'
TS_PROG3: C39.1, JP28.4, PROGRAM3.A, PROGRAM3.A'
TS_RESET: C8.1, JP4.5, RESET.A, RESET.A'
TS_RESET1: C18.1, JP12.5, RESET1.A, RESET1.A'
TS_RESET2: C28.1, JP20.5, RESET2.A, RESET2.A'
TS_RESET3: C38.1, JP28.5, RESET3.A, RESET3.A'
UART1_RXD: JP2.13, U3.P14
UART1_RXD1: JP10.13, U6.P14
UART1_RXD2: JP18.13, U9.P14
UART1_RXD3: JP26.13, U12.P14
UART1_TXD: JP2.12, U3.P13
UART1_TXD1: JP10.12, U6.P13
UART1_TXD2: JP18.12, U9.P13
UART1_TXD3: JP26.12, U12.P13
VBAT: J1.P2, PTC.2, U1.P3, U2.P2
VBAT1: J2.P2, PTC1.2, U4.P3, U5.P2
VBAT2: J3.P2, PTC2.2, U7.P3, U8.P2
VBAT3: J4.P2, PTC3.2, U10.P3, U11.P2
VCCIO: C2.1, C3.2, C5.1, C7.1, C10.1, JP7.P6, JP8.P3, LDO1.3, LED2.A, LED3.A, U2.P3, U3.P8
VCCIO1: C12.1, C13.2, C15.1, C17.1, C20.1, JP15.P6, JP16.P3, LDO2.3, LED5.A, LED6.A, U5.P3, U6.P8
VCCIO2: C22.1, C23.2, C25.1, C27.1, C30.1, JP23.P6, JP24.P3, LDO3.3, LED8.A, LED9.A, U8.P3, U9.P8
VCCIO3: C32.1, C33.2, C35.1, C37.1, C40.1, JP31.P6, JP32.P3, LDO4.3, LED11.A, LED12.A, U11.P3, U12.P8
VIN: C1.1, C6.1, J1.P4, JP3.14, LDO1.1
VIN1: C11.1, C16.1, J2.P4, JP11.14, LDO2.1
VIN2: C21.1, C26.1, J3.P4, JP19.14, LDO3.1
VIN3: C31.1, C36.1, J4.P4, JP27.14, LDO4.1
VUSB: JP5.1, LED1.A, U1.P4
VUSB1: JP13.1, LED4.A, U4.P4
VUSB2: JP21.1, LED7.A, U7.P4
VUSB3: JP29.1, LED10.A, U10.P4
