downbeat/senseye/software/v2/embedded/smartfusion_libero/senseye/component/Actel/DirectCore/CoreAHBLite/3.1.102/rtl/vlog/core_obfuscated/coreahblite.v

// Actel Corporation Proprietary and Confidential
// Copyright 2010 Actel Corporation.  All rights reserved.
// ANY USE OR REDISTRIBUTION IN PART OR IN WHOLE MUST BE HANDLED IN
// ACCORDANCE WITH THE ACTEL LICENSE AGREEMENT AND MUST BE APPROVED
// IN ADVANCE IN WRITING.
// Revision Information:
// 10Feb10		Production Release Version 3.1
// SVN Revision Information:
// SVN $Revision: 11146 $
// SVN $Date: 2009-11-21 11:44:53 -0800 (Sat, 21 Nov 2009) $
`timescale 1ns/1ps
module
CoreAHBLite
#
(
parameter
[
5
:
0
]
FAMILY
=
17
,
parameter
[
0
:
0
]
MODE_CFG
=
0
,
parameter
[
0
:
0
]
M0_AHBSLOT0ENABLE
=
1
,
parameter
[
0
:
0
]
M0_AHBSLOT1ENABLE
=
0
,
parameter
[
0
:
0
]
M0_AHBSLOT2ENABLE
=
0
,
parameter
[
0
:
0
]
M0_AHBSLOT3ENABLE
=
0
,
parameter
[
0
:
0
]
M0_AHBSLOT4ENABLE
=
0
,
parameter
[
0
:
0
]
M0_AHBSLOT5ENABLE
=
0
,
parameter
[
0
:
0
]
M0_AHBSLOT6ENABLE
=
0
,
parameter
[
0
:
0
]
M0_AHBSLOT7ENABLE
=
0
,
parameter
[
0
:
0
]
M0_AHBSLOT8ENABLE
=
0
,
parameter
[
0
:
0
]
M0_AHBSLOT9ENABLE
=
0
,
parameter
[
0
:
0
]
M0_AHBSLOT10ENABLE
=
0
,
parameter
[
0
:
0
]
M0_AHBSLOT11ENABLE
=
0
,
parameter
[
0
:
0
]
M0_AHBSLOT12ENABLE
=
0
,
parameter
[
0
:
0
]
M0_AHBSLOT13ENABLE
=
0
,
parameter
[
0
:
0
]
M0_AHBSLOT14ENABLE
=
0
,
parameter
[
0
:
0
]
M0_AHBSLOT15ENABLE
=
0
,
parameter
[
0
:
0
]
M1_AHBSLOT0ENABLE
=
1
,
parameter
[
0
:
0
]
M1_AHBSLOT1ENABLE
=
0
,
parameter
[
0
:
0
]
M1_AHBSLOT2ENABLE
=
0
,
parameter
[
0
:
0
]
M1_AHBSLOT3ENABLE
=
0
,
parameter
[
0
:
0
]
M1_AHBSLOT4ENABLE
=
0
,
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
(
MODE_CFG
==
1
)
begin
:
CAHBLTIl0
if
(
HADDR_SHG_CFG
==
0
)
begin
:
CAHBLTl1I0l
assign
HADDR_SHG
[
31
]
=
1
'b
0
;
end
else
if
(
HADDR_SHG_CFG
==
1
)
begin
:
CAHBLTOOl0l
assign
HADDR_SHG
[
31
]
=
1
'b
1
;
end
end
end
endgenerate
assign
HADDR_SHG
[
30
:
0
]
=
CAHBLTl0I0l
[
30
:
0
]
;
endmodule
