downbeat/senseye/software/v2/embedded/smartfusion_libero/senseye/component/Actel/DirectCore/CoreAHBLite/3.1.102/rtl/vlog/core_obfuscated/coreahblite_masterstage.v

// Actel Corporation Proprietary and Confidential
// Copyright 2010 Actel Corporation.  All rights reserved.
// ANY USE OR REDISTRIBUTION IN PART OR IN WHOLE MUST BE HANDLED IN
// ACCORDANCE WITH THE ACTEL LICENSE AGREEMENT AND MUST BE APPROVED
// IN ADVANCE IN WRITING.
// Revision Information:
// 10Feb10		Production Release Version 3.1
// SVN Revision Information:
// SVN $Revision: 11955 $
// SVN $Date: 2010-01-30 15:35:13 -0800 (Sat, 30 Jan 2010) $
`timescale 1ns/1ps
module
CAHBLTO0OI
#
(
parameter
[
0
:
0
]
MODE_CFG
=
0
,
parameter
[
16
:
0
]
CAHBLTI
=
(
2
**
17
)
-
1
,
parameter
[
15
:
0
]
CAHBLTl
=
0
)
(
input
HCLK,
input
HRESETN,
input
[
31
:
0
]
CAHBLTI0OI,
input
CAHBLTl0OI,
input
[
2
:
0
]
CAHBLTO1OI,
input
CAHBLTI1OI,
input
CAHBLTl1OI,
output
reg
CAHBLTOOII,
output
reg
[
31
:
0
]
CAHBLTIOII,
output
wire
CAHBLTlOII,
input
CAHBLTII,
input
[
16
:
0
]
CAHBLTOIII,
input
[
16
:
0
]
CAHBLTIIII,
input
[
16
:
0
]
CAHBLTlIII,
input
CAHBLTOlII,
input
CAHBLTIlII,
input
CAHBLTllII,
output
wire
[
31
:
0
]
CAHBLTO0II,
output
reg
CAHBLTI0II,
output
reg
[
2
:
0
]
CAHBLTl0II,
output
reg
CAHBLTO1II,
output
reg
CAHBLTI1II,
output
wire
[
16
:
0
]
CAHBLTl1II,
output
wire
[
16
:
0
]
CAHBLTOOlI,
output
wire
[
15
:
0
]
CAHBLTIOlI,
output
wire
CAHBLTlOlI,
output
wire
CAHBLTOIlI,
output
reg
CAHBLTIIlI,
input
[
31
:
0
]
HRDATA_S0,
input
HREADYOUT_S0,
input
[
31
:
0
]
HRDATA_S1,
input
HREADYOUT_S1,
input
[
31
:
0
]
HRDATA_S2,
input
HREADYOUT_S2,
input
[
31
:
0
]
HRDATA_S3,
input
HREADYOUT_S3,
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
;
CAHBLTI0lI
<=
1
'b
0
;
end
else
begin
CAHBLTOI0I
<=
CAHBLTII0I
;
CAHBLTI0lI
<=
CAHBLTl0lI
;
end
end
CAHBLTO10
CAHBLTI0Il
(
.HCLK
(
HCLK
)
,
.HRESETN
(
HRESETN
)
,
.CAHBLTI10
(
CAHBLTI10
)
,
.CAHBLTl10
(
CAHBLTl10
)
,
.CAHBLTOO1
(
CAHBLTOO1
)
)
;
assign
CAHBLTlOII
=
CAHBLTllIl
;
endmodule
