downbeat/senseye/software/v2/embedded/smartfusion_libero/senseye/component/Actel/DirectCore/CoreAHBLite/3.1.102/rtl/vlog/core_obfuscated/coreahblite_matrix2x16.v

// Actel Corporation Proprietary and Confidential
// Copyright 2010 Actel Corporation.  All rights reserved.
// ANY USE OR REDISTRIBUTION IN PART OR IN WHOLE MUST BE HANDLED IN
// ACCORDANCE WITH THE ACTEL LICENSE AGREEMENT AND MUST BE APPROVED
// IN ADVANCE IN WRITING.
// Revision Information:
// 10Feb10		Production Release Version 3.1
// SVN Revision Information:
// SVN $Revision: 11955 $
// SVN $Date: 2010-01-30 15:35:13 -0800 (Sat, 30 Jan 2010) $
`timescale 1ns/1ps
module
CAHBLTlOl0
#
(
parameter
[
0
:
0
]
MODE_CFG
=
0
,
parameter
[
16
:
0
]
CAHBLTOIl0
=
(
2
**
17
)
-
1
,
parameter
[
16
:
0
]
CAHBLTIIl0
=
(
2
**
17
)
-
1
,
parameter
[
15
:
0
]
CAHBLTO0O0
=
0
,
parameter
[
15
:
0
]
CAHBLTI0O0
=
0
)
(
input
HCLK,
input
HRESETN,
input
REMAP_M0,
input
[
31
:
0
]
HADDR_M0,
input
HMASTLOCK_M0,
input
[
2
:
0
]
HSIZE_M0,
input
HTRANS_M0,
input
HWRITE_M0,
input
[
31
:
0
]
HWDATA_M0,
output
wire
HRESP_M0,
output
wire
[
31
:
0
]
HRDATA_M0,
output
wire
HREADY_M0,
input
[
31
:
0
]
HADDR_M1,
input
HMASTLOCK_M1,
input
[
2
:
0
]
HSIZE_M1,
input
HTRANS_M1,
input
HWRITE_M1,
input
[
31
:
0
]
HWDATA_M1,
output
wire
HRESP_M1,
output
wire
[
31
:
0
]
HRDATA_M1,
output
wire
HREADY_M1,
input
[
31
:
0
]
HRDATA_S0,
input
HREADYOUT_S0,
input
HRESP_S0,
output
wire
HSEL_S0,
output
wire
[
31
:
0
]
HADDR_S0,
output
wire
[
2
:
0
]
HSIZE_S0,
output
wire
HTRANS_S0,
output
wire
HWRITE_S0,
output
wire
[
31
:
0
]
HWDATA_S0,
output
wire
HREADY_S0,
output
wire
HMASTLOCK_S0,
input
[
31
:
0
]
HRDATA_S1,
input
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
.CAHBLTOOlI
(
{
CAHBLTlO0OI
,
CAHBLTIllOI
,
CAHBLTO1IOI
,
CAHBLTlOIOI
,
CAHBLTIlOOI
,
CAHBLTO111
,
CAHBLTlO11
,
CAHBLTIl01
,
CAHBLTO1l1
,
CAHBLTlOl1
,
CAHBLTIlI1
,
CAHBLTO1O1
,
CAHBLTlOO1
,
CAHBLTIl10
,
CAHBLTO100
,
CAHBLTlO00
,
CAHBLTIll0
}
)
,
.CAHBLTIOlI
(
CAHBLTl0O0
[
15
:
0
]
)
,
.CAHBLTlOlI
(
CAHBLTl00OI
)
,
.CAHBLTOIlI
(
CAHBLTO10OI
)
,
.CAHBLTIIlI
(
CAHBLTlIl0
)
,
.HRDATA_S0
(
CAHBLTllI0I
)
,
.HREADYOUT_S0
(
CAHBLTO100I
)
,
.HRDATA_S1
(
CAHBLTO0I0I
)
,
.HREADYOUT_S1
(
CAHBLTI100I
)
,
.HRDATA_S2
(
CAHBLTI0I0I
)
,
.HREADYOUT_S2
(
CAHBLTl100I
)
,
.HRDATA_S3
(
CAHBLTl0I0I
)
,
.HREADYOUT_S3
(
CAHBLTOO10I
)
,
.HRDATA_S4
(
CAHBLTO1I0I
)
,
.HREADYOUT_S4
(
CAHBLTIO10I
)
,
.HRDATA_S5
(
CAHBLTI1I0I
)
,
.HREADYOUT_S5
(
CAHBLTlO10I
)
,
.HRDATA_S6
(
CAHBLTl1I0I
)
,
.HREADYOUT_S6
(
CAHBLTOI10I
)
,
.HRDATA_S7
(
CAHBLTOOl0I
)
,
.HREADYOUT_S7
(
CAHBLTII10I
)
,
.HRDATA_S8
(
CAHBLTIOl0I
)
,
.HREADYOUT_S8
(
CAHBLTlI10I
)
,
.HRDATA_S9
(
CAHBLTlOl0I
)
,
.HREADYOUT_S9
(
CAHBLTOl10I
)
,
.HRDATA_S10
(
CAHBLTOIl0I
)
,
.HREADYOUT_S10
(
CAHBLTIl10I
)
,
.HRDATA_S11
(
CAHBLTIIl0I
)
,
.HREADYOUT_S11
(
CAHBLTll10I
)
,
.HRDATA_S12
(
CAHBLTlIl0I
)
,
.HREADYOUT_S12
(
CAHBLTO010I
)
,
.HRDATA_S13
(
CAHBLTOll0I
)
,
.HREADYOUT_S13
(
CAHBLTI010I
)
,
.HRDATA_S14
(
CAHBLTIll0I
)
,
.HREADYOUT_S14
(
CAHBLTl010I
)
,
.HRDATA_S15
(
CAHBLTlll0I
)
,
.HREADYOUT_S15
(
CAHBLTO110I
)
,
.HRDATA_SHG
(
CAHBLTO0l0I
)
,
.HREADYOUT_SHG
(
CAHBLTI110I
)
,
.CAHBLTlIlI
(
CAHBLTl110I
)
)
;
CAHBLTO0OI
#
(
.MODE_CFG
(
MODE_CFG
)
,
.CAHBLTI
(
CAHBLTIIl0
)
,
.CAHBLTl
(
CAHBLTI0O0
)
)
CAHBLTIlO0l
(
.HCLK
(
HCLK
)
,
.HRESETN
(
HRESETN
)
,
.CAHBLTII
(
1
'b
0
)
,
.CAHBLTI0OI
(
HADDR_M1
)
,
.CAHBLTl0OI
(
HMASTLOCK_M1
)
,
.CAHBLTO1OI
(
HSIZE_M1
)
,
.CAHBLTI1OI
(
HTRANS_M1
)
,
.CAHBLTl1OI
(
HWRITE_M1
)
,
.CAHBLTOOII
(
HRESP_M1
)
,
.CAHBLTIOII
(
HRDATA_M1
)
,
.CAHBLTlOII
(
CAHBLTlIO0l
)
,
.CAHBLTOIII
(
{
CAHBLTO0O0I
,
CAHBLTl11lI
,
CAHBLTII1lI
,
CAHBLTO00lI
,
CAHBLTl1llI
,
CAHBLTIIllI
,
CAHBLTO0IlI
,
CAHBLTl1OlI
,
CAHBLTIIOlI
,
CAHBLTO01II
,
CAHBLTl10II
,
CAHBLTII0II
,
CAHBLTO0lII
,
CAHBLTl1III
,
CAHBLTIIIII
,
CAHBLTO0OII
,
CAHBLTl11OI
}
)
,
.CAHBLTIIII
(
{
CAHBLTI0O0I
,
CAHBLTOOO0I
,
CAHBLTlI1lI
,
CAHBLTI00lI
,
CAHBLTOO0lI
,
CAHBLTlIllI
,
CAHBLTI0IlI
,
CAHBLTOOIlI
,
CAHBLTlIOlI
,
CAHBLTI01II
,
CAHBLTOO1II
,
CAHBLTlI0II
,
CAHBLTI0lII
,
CAHBLTOOlII
,
CAHBLTlIIII
,
CAHBLTI0OII
,
CAHBLTOOOII
}
)
,
.CAHBLTlIII
(
{
CAHBLTl0O0I
,
CAHBLTIOO0I
,
CAHBLTOl1lI
,
CAHBLTl00lI
,
CAHBLTIO0lI
,
CAHBLTOlllI
,
CAHBLTl0IlI
,
CAHBLTIOIlI
,
CAHBLTOlOlI
,
CAHBLTl01II
,
CAHBLTIO1II
,
CAHBLTOl0II
,
CAHBLTl0lII
,
CAHBLTIOlII
,
CAHBLTOlIII
,
CAHBLTl0OII
,
CAHBLTIOOII
}
)
,
.CAHBLTOlII
(
CAHBLTIII0I
)
,
.CAHBLTIlII
(
CAHBLTlII0I
)
,
.CAHBLTllII
(
CAHBLTOlI0I
)
,
.CAHBLTO0II
(
CAHBLTI0ll
)
,
.CAHBLTI0II
(
CAHBLTO01
)
,
.CAHBLTl0II
(
CAHBLTl0ll
)
,
.CAHBLTO1II
(
CAHBLTO1ll
)
,
.CAHBLTI1II
(
CAHBLTI1ll
)
,
.CAHBLTl1II
(
{
CAHBLTlOO0I
,
CAHBLTIl1lI
,
CAHBLTO10lI
,
CAHBLTlO0lI
,
CAHBLTIlllI
,
CAHBLTO1IlI
,
CAHBLTlOIlI
,
CAHBLTIlOlI
,
CAHBLTO11II
,
CAHBLTlO1II
,
CAHBLTIl0II
,
CAHBLTO1lII
,
CAHBLTlOlII
,
CAHBLTIlIII
,
CAHBLTO1OII
,
CAHBLTlOOII
,
CAHBLTIl1OI
}
)
,
.CAHBLTOOlI
(
{
CAHBLTOIO0I
,
CAHBLTll1lI
,
CAHBLTI10lI
,
CAHBLTOI0lI
,
CAHBLTllllI
,
CAHBLTI1IlI
,
CAHBLTOIIlI
,
CAHBLTllOlI
,
CAHBLTI11II
,
CAHBLTOI1II
,
CAHBLTll0II
,
CAHBLTI1lII
,
CAHBLTOIlII
,
CAHBLTllIII
,
CAHBLTI1OII
,
CAHBLTOIOII
,
CAHBLTll1OI
}
)
,
.CAHBLTIOlI
(
CAHBLTO1O0
[
15
:
0
]
)
,
.CAHBLTlOlI
(
CAHBLTO1O0I
)
,
.CAHBLTOIlI
(
CAHBLTI1O0I
)
,
.CAHBLTIIlI
(
CAHBLTOl1OI
)
,
.HRDATA_S0
(
CAHBLTI0l0I
)
,
.HREADYOUT_S0
(
CAHBLTOOO1I
)
,
.HRDATA_S1
(
CAHBLTl0l0I
)
,
.HREADYOUT_S1
(
CAHBLTIOO1I
)
,
.HRDATA_S2
(
CAHBLTO1l0I
)
,
.HREADYOUT_S2
(
CAHBLTlOO1I
)
,
.HRDATA_S3
(
CAHBLTI1l0I
)
,
.HREADYOUT_S3
(
CAHBLTOIO1I
)
,
.HRDATA_S4
(
CAHBLTl1l0I
)
,
.HREADYOUT_S4
(
CAHBLTIIO1I
)
,
.HRDATA_S5
(
CAHBLTOO00I
)
,
.HREADYOUT_S5
(
CAHBLTlIO1I
)
,
.HRDATA_S6
(
CAHBLTIO00I
)
,
.HREADYOUT_S6
(
CAHBLTOlO1I
)
,
.HRDATA_S7
(
CAHBLTlO00I
)
,
.HREADYOUT_S7
(
CAHBLTIlO1I
)
,
.HRDATA_S8
(
CAHBLTOI00I
)
,
.HREADYOUT_S8
(
CAHBLTllO1I
)
,
.HRDATA_S9
(
CAHBLTII00I
)
,
.HREADYOUT_S9
(
CAHBLTO0O1I
)
,
.HRDATA_S10
(
CAHBLTlI00I
)
,
.HREADYOUT_S10
(
CAHBLTI0O1I
)
,
.HRDATA_S11
(
CAHBLTOl00I
)
,
.HREADYOUT_S11
(
CAHBLTl0O1I
)
,
.HRDATA_S12
(
CAHBLTIl00I
)
,
.HREADYOUT_S12
(
CAHBLTO1O1I
)
,
.HRDATA_S13
(
CAHBLTll00I
)
,
.HREADYOUT_S13
(
CAHBLTI1O1I
)
,
.HRDATA_S14
(
CAHBLTO000I
)
,
.HREADYOUT_S14
(
CAHBLTl1O1I
)
,
.HRDATA_S15
(
CAHBLTI000I
)
,
.HREADYOUT_S15
(
CAHBLTOOI1I
)
,
.HRDATA_SHG
(
CAHBLTl000I
)
,
.HREADYOUT_SHG
(
CAHBLTIOI1I
)
,
.CAHBLTlIlI
(
CAHBLTlOI1I
)
)
;
CAHBLTl0Il
CAHBLTllO0l
(
.HCLK
(
HCLK
)
,
.HRESETN
(
HRESETN
)
,
.CAHBLTO1Il
(
CAHBLTOII1I
)
,
.CAHBLTOOII
(
CAHBLTlIl1I
)
,
.CAHBLTI1Il
(
HSEL_S0
)
,
.CAHBLTI0OI
(
HADDR_S0
)
,
.CAHBLTO1OI
(
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
}
)
,
.CAHBLTOIll
(
{
CAHBLTII0lI
,
CAHBLTOIIOI
}
)
,
.CAHBLTIIll
(
{
CAHBLTlI0lI
,
CAHBLTIIIOI
}
)
,
.CAHBLTlIll
(
{
CAHBLTOl0lI
,
CAHBLTlIIOI
}
)
,
.CAHBLTOlll
(
CAHBLTl0IOl
)
,
.CAHBLTll1
(
CAHBLTllIIl
)
,
.CAHBLTIlll
(
CAHBLTlO1Ol
)
,
.CAHBLTllll
(
CAHBLTl10Il
)
,
.CAHBLTO0ll
(
CAHBLTlIIll
)
,
.CAHBLTI0ll
(
CAHBLTl1lOl
)
,
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
