downbeat/senseye/(commit log)

2012-10-19 initial check-in
    this check-in contains the basic arduino embedded code for the glasses
    as well as some opencv code to capture video from the glasses via USB.
    there is also some simple test code (for example
    "sw/embedded/impl/sketch_drvStony").
2012-10-20 updates for the EGGs alpha 1!
    stonymask_cam4.h for the 4th camera's mask. updated grabvid.c to write
    out BMP files and the instantaeus FPS between each consecutive frame to
    an attributes file.
2012-10-20 accidentally forgot to stage grabvid.c, here it is
    adds onto the previous commit with grabvid.c. I forgot to stage it
    before committing.
2012-10-27 finished alpha1 code for cameracapture
    finished the alpha 1 code for cameracapture, the arduino sketch for glasses
2012-10-27 updated sketch_drvStony to support 3v3 operation
    although 3v3 operation is still not working, I have added the changed
    made to the cameracapture sketch into the sketch_drvStony, which is
    still being used to obtain the FPN calibration masks for the cameras.
2012-10-27 added the captureFrame program
    added the captureFrame program to sw/embedded/testandmeasurement/. this
    program captures a single frame from the USB attached camera (on
    /dev/ttyACM0 for now), and outputs it for matlab into image.m (for now).
2012-10-27 added a new mask for camera 5 (running at 5v)
2012-10-27 ignoring 'sample' folder for captureStream
    the captureStream program saves videos as a stream of .bmp files into a
    folder called samples (for now). this should be changed to be specified
    at the command line, but currently that's not done. so, for now, this
    samples folder ought to be ignored.
2012-10-28 android/teensy usb otg + frame capture
    added files for the usb serial interface between teensy and android.
    also added code that captures frames from the teensy
    [proguard.cfg]
2012-10-29 added opencv functionality to android framecapture code
    added opencv libraries, and framecapture is now successfully displaying
    pixel data.
    KNOWN ISSUES: drops pixels when sending frame 1 row at a time
2012-10-31 dual cameras are support (front and rear)
    there is code to support 2 cameras for both the glasses (teensy) and the
    PC. it's not great code, but it's working
2012-11-01 captureStreamDual displays both cams in one window
    the captureStreamDual app for linux will now display the video from both
    cameras in one window side-by-side.
2012-11-02 added graceful exits to captureStreamDual
    captureStreamDual will now teardown the camera connection upon a Ctrl-C
    (and some other terminating signals) or if an assertion is hit.
2012-11-03 workaround for front camera pixel value wrap bug
    added a workaround to dualcameracapture sketch to fix the bug with the
    front camera (camera #9) where very dark pixels were wrapping around
    the 8-bit space and becoming white
2012-11-06 added 3v3 camera code to sketch_drvStony.ino
    added the 3v3 camera code to sketch_drvStony, which is the calibration
    mask sketch. the 3v3 code is commented out.
2012-11-06 added some commented out code for UART bluetooth
    added some commented out code for UART bluetooth to the calibration mask
    computation sketch (sketch_drvStony)
2012-11-06 renamed sketch_drvStony to calibrationcalculation
2012-11-06 added symlink calibrationcalculation to ardueye
    added a symlink pointing to the ardueye python folder named
    calibrationcalculation to indicate the tool to use for calculation.
2012-11-06 renamed opencv_android folder to android
    [proguard.cfg]
2012-11-08 captureStream/Dual has "step mode"
    captureStream and captureStreamDual now have "step mode", where the
    camera grabs single frames at a time instead of continuously streaming.
    the function waits on user input before grabbing the next frame. As
    with stream mode, the ESC key ends the program. captureFrame is now
    essentially obsolete and I might even delete it from the repo.
2012-11-09 added bluetooth cli switch for captureStream/Dual
2012-11-10 added an SOF delimiter to single camera variants
    added an SOF delimiter to single camera variants. Ctrl-C no longer
    works (it never really worked right).
2012-11-10 updated the dual camera variants to have SOF too
2012-11-10 captureStreamDual now gets the number of cameras
2012-11-10 captureStreamDual now handles 2 cameras or 1
    captureStreamDual now handles both 1 and 2 camera variants. Instead of
    letting the user choose, the program asks the glasses device how many
    cameras it has.
2012-11-10 squashed the front camera contrast bug!
    there was a bug which was leading to really poor contrast on the front
    camera. Initially I thought it was something with the camera, but
    noticied it was doing the same thing on my breadboard ONLY with the
    second camera (the "front" camera). well, this was that bug, and it's
    dead now.
2012-11-15 Add Eagle files for Teensy shield
    [main-old.brd, main-stencil.dxf, main.brd, main.dxf, main.sch, panel.brd]
2012-11-26 fixed a "bug" where all serial data is not read
    fixed a "bug" in cameracapture where all serial data is not read. I
    believe it was already fixed in dualcameracapture. also, made a few
    changes to dualcameracapture to make the two files more the same.
2012-11-26 actually checking in changes to dual variant
    actually checking in the changes to dualcameracapture.ino that make it
    have some of the (cosmetic) changes to cameracapture.ino
2012-11-26 removed all arduino-ness. it's all CPP now.
    changed over the main arduino sketches to raw CPP using make files and
    the teensy loader.
2012-11-28 frontdisplayandsave prints frame index on stdout
2012-12-06 ml_rawfeatures_knearest__replayhack
    This is dirty as the night is long. I was crunched for time when I
    wrote this, and it still belongs in the repo even if it is dirty.
    The ML algorithm programs should either save state for later replay (or
    processing) or, alternatively, continue pipe data for another program to
    attach to.
2012-12-06 added hardware specific variants for the PCBs
2012-12-06 Add RTS/CTS flow control support for UART0
2012-12-10 added the script which randomizes a data set
    added the program 'randomizeondisk' which takes an in order data capture
    and outputs it in random order. the data set must have frames and an
    attributes file with human labels.
2012-12-10 ml_eval accepts -c for a folder of data folders
    the ml_eval program now accepts the command line flag -c (for composite
    input). If composite input is specificed, the program assumes that the
    directory specified contiains a number of subdirectories each containing
    eye and gaze location ground truth data.
2012-12-10 frontdisplayandsave: 'q' quits, grid display optio
    frontdisplayandsave now quits with 'q' instead of <ESC>. Also, it has a
    -g flag, which, if supplied, draws a grid on ths scene window (I believe
    it's red).
2012-12-12 switched the wireless camera variants to defaults
2012-12-26 added (now unused) defines for Boyan's 3v3 values
    added #defines for the camera attributes (vref, nbias, aobias, gain and
    selamp) based on what Boyan gave me. They didn't work on a brief test,
    so they are currently unused.
2012-12-26 gazesetgroundtruth: ability to mark junk frames
    gazesetgroundtruth now allows the marking of "junk" frames with the 'j'
    key. bad frames are blinks or smears whereas junk frames are frames
    which weren't even part of the experiment.
2012-12-26 gazesetgroundtruth: junk frames also marked bad
    gazesetgroundtruth: all junk frames are also automatically marked as bad
2012-12-26 fronteyedetect, frontgazecoordsoverlay: 'q' quits
    in fronteyedetect and frontgazecoordsoverlay, the 'q' key is now used to
    quit instead of the ESC key
2012-12-26 glasses_cv now includes glassesSplitImages routine
    added glassesSplitImages routine to glasses_cv.h/c to facilitate
    splitting of a dual image into two seperate images. this function takes
    a width and height parameter, but as with the rest of the code, expected
    the frames to be the same resolution (side-by-side).
2012-12-26 oldmonolithicglassescapture: no more cmake
    oldmonolithicglassescapture: removed cmake and switched to standard
    makefile
2012-12-26 oldmonolithicglassescapture: quit with 'q'
    changed oldmonolithicglassescapture to quit with 'q' instead of ESC
2012-12-26 cameracapture: using "nomask" mask
    using the "nomask" mask for cameracapture, because there are no masks
    calculated for 3V3 operation of the cameras.
2012-12-28 glassescapstream: updated help text
    updated the help text for glassescapstream removing the line about using
    the ESC key to quit (which was never really true)
2012-12-28 dualcameracapture: final for wireless glasses!
    this is the final code for the wireless glasses. I have used Boyan's
    values for the Stonyman cameras (vref, nbias, aobias, gain and selamp).
    Camera 7 is the eye camera and camera 6 is the scene camera.
2012-12-28 updated cameracapture to match updates to dual...
    updated cameracapture to match updates to dualcameracapture.
    Specifically, now we can switch between USB and Bluetooth by changing a
    preprocessor define.
2012-12-28 made hw/impl directory and moved eagle files there
    created a hw/impl directly which mirrors the rest of the repo and moved
    the eagle files there (specifically, the teensy-shield)
    [main-old.brd, main-stencil.dxf, main.brd, main.dxf, main.sch, panel.brd]
2013-02-06 created the capture libero project
    created the capture libero project for connecting the camera to the uSDR
    board. it has two verilog files, one to blink an LED and an empty one
    for connecting to the camera.
    [_vhdl.psm, body.psm, mss_capture.sdf, rtl.psm, verilog.psm]
2013-02-07 moved pcb files into their own directory
    created a directory /hw/pcb and put the two eagle projects,
    cmos_camera_breakout and teensy-shield into said folder
    [main-old.brd, main-stencil.dxf, main.brd, main.dxf, main.sch, panel.brd]
2013-02-08 displays ADC data on LEDs (MCP ADC)
    code now displays ADC values on the LEDs (higher values light more
    LEDs). This works with the MCP3201, but I think that there are still
    bugs.
    [mss_capture.sdf]
2013-02-09 changed ADC driver to TI ADC081S101, tested
    changed the ADC driver to the TI ADC081S101 and tested it with the
    scope. the test stub kicks off a new capture every 0.5s. The ADC is
    captured and the value is encoded in the LEDs. It is running at 100Msps
    (20MHz clock).
    [mss_capture.sdf]
2013-02-11 AdcCap.v now implemented proper timing
    the adc driver (AdcCap.v) now implements the proper timing for the TI
    ADC081S101 ADC. also checked in is everything else libero felt like
    changing.
    [mss_capture.sdf]
2013-02-11 deleted AdcDisplayStub.v, removed from Libero proj
    deleted AdcDisplayStub.v, which displayed the ADC's value on the LEDs
    like an EQ knob (lighting more lights with larger values). With the
    8-bit ADC, I just dump the contents directly to the LEDs every 0.5s
    (that's how often the AdcCapStub.v test file triggers the capture).
2013-02-11 added more version comments to AdcCap.v
    added a version comment to AdcCap.v for 1.00, which is the finished and
    working driver for the TI ADC081S101
2013-02-11 fixed the description comment for the ADC driver
    fixed the description comment for the TI ADC081S101 ADC driver
    (AdcCap.h). It still had the outdated text for the MCP3201
2013-02-13 capture_linux folder from Ye-Sheng's Libero proj
    created capture_linux folder from Ye-Sheng's Libero proj. this is the
    project exactly as it came out of the zip archive
    [TOPLEVEL.sdf, _vhdl.psm, body.psm, rtl.psm, verilog.psm]
2013-02-20 stonyman.v now runs the init sequence
    stonyman.v now works to initialize the camera
    [mss_capture.sdf]
2013-02-26 got capture_linux project working with libero 10
    got capture_linux project working with libero 10. I had to install
    Libero 9 take a screenshot of the I/O assignments and manually copy
    those settings over to the Libero 10 project.
    [TOPLEVEL.sdf, verilog.psm]
2013-02-26 renamed capture_linux project to meyesight
    renamed capture_linux project to meyesight, which is to be the new name
    of the project (MEyeSight is replacing InSight as the project's name).
    [TOPLEVEL.sdf, _vhdl.psm, body.psm, rtl.psm, verilog.psm]
2013-02-26 reorganized hw dir to match the sw dir (and rest)
    reorganized the hw directory to match the format of the other
    directories in this repo, specifically the sw directory.
    [TOPLEVEL.sdf, _vhdl.psm, body.psm, main-old.brd, main-stencil.dxf, main.brd, main.dxf, main.sch]
2013-02-26 changed permissions, most of the repo was modified
    changed file permissions and now most of the repo thinks it was changed.
    so, I'm checking it in! marking ALL files as not executable. Some
    files like ardueyectrl.py or seriallistener.py should actually be
    executable. remark them as such when the time comes that you need to do
    so.
    [_vhdl.psm, body.psm, mss_capture.sdf, rtl.psm, verilog.psm]
2013-02-26 added the rest of the stonyman.v code
    added the stonyman.v code for operating the camera. however, it won't
    exit the S_IDLE state after initialization (hardcoded), because that
    code's not tested yet.
    [mss_capture.sdf]
2013-02-26 changed INPHI to use Fabric_IO 5 instead of 4
    changed INPHI to use Fabric_IO 5 instead of 4, because that pin is in
    use in the linux project, so I'm just changing capture to match.
2013-02-26 incorporated stonyman driver into meyesight proj
    incorporated stonyman driver into meyesight proj, which is the
    linux-based project for capturing.
    [TOPLEVEL.sdf, verilog.psm]
2013-02-26 made clkgenerate.v not executable
    made clkgenerate.v not executable (all these permissions problems are
    caused by windows or libero or both)
    [clkgenerator.v]
2013-02-26 fixed bug in stonyman.v driver with delay lengs
    fixed bug in stonyman.v driver with delay lengs, which were 1 tick too
    long in some states.
    [stonyman.v]
2013-02-27 attempted to fix stonyman timing bug
    attempted to fix stonyman timing bug where the delay after lowering the
    stonyman pin is 350 instead of 300ns as expected. it didn't actually
    seem to work. I'm checking it in anyway.
    [TOPLEVEL.sdf]
2013-02-27 attached GPIO 0 and 1 to LEDs 0 and 1
    attached GPIO 0 and 1 to LEDs 0 and 1 to later be controlled by software
    running on the uSDR (under linux). currently, they are not used.
    [TOPLEVEL.sdf, verilog.psm]
2013-03-01 replaced some verilog in capture proj w symlinks
    replaced some verilog files (stonyman.v and adc081s101.v) in capture
    proj with symlinks to the same files in the meyesight projects.
    [stonyman.v]
2013-03-01 fixed some bugs (mainly in stonyman.v)
    fixed some bugs (mainly in stonyman.v), but the interface between the
    stonyman driver and the ADC driver is updated too. the primary bug is
    the reset bug in stonyman.v (but maybe primary is incorrect, as other
    bugs were large too). The stonyman driver is still getting stuck during
    picture capture somewhere.
    [TOPLEVEL.sdf, TOPLEVEL_ba.sdf, _vhdl.psm, body.psm, rtl.psm, verilog.psm]
2013-03-01 renamed meyesight to insight
    renamed meyesight to insight. going back to the trusted name insight
    for now.
    [TOPLEVEL.sdf, TOPLEVEL_ba.sdf, _vhdl.psm, body.psm, rtl.psm, verilog.psm]
2013-03-02 the stonyman driver works
    the stonyman driver works (I think). unless there is a counting error
    with the pixels (unlikely), it works.
    [TOPLEVEL.sdf]
2013-03-04 reorganized smartfusion directory
    reorganized smartfusion directory to have the libero projects in their
    own subdirectory. there will be a new uclinux directory for uClinux
    development work.
    [TOPLEVEL.sdf, TOPLEVEL_ba.sdf, _vhdl.psm, body.psm, mss_capture.sdf, rtl.psm, verilog.psm]
2013-03-04 moved smartfusion dir from hw to sw
    moved smartfusion dir from hw to sw since it is basically software
    [TOPLEVEL.sdf, TOPLEVEL_ba.sdf, _vhdl.psm, body.psm, mss_capture.sdf, rtl.psm, verilog.psm]
2013-03-06 created counter with a FIFO and APB3 interface
    created counter with a FIFO and APB3 interface to test my setup. it
    works. Now I will add support for the FIFO and APB3 interface for the
    camera.
    [TOPLEVEL.sdf]
2013-03-06 created an APB3 interface for the stonyman driver
    created an APB3 interface for the stonyman driver. it seems to work (in
    that it returns the expected number of pixels and it returns reasonable
    pixel values).
    [TOPLEVEL.sdf]
2013-03-06 completed working stonyman interface over the APB
    completed working stonyman interface over the APB. it's not beautiful
    or complete, but it works. the program stonyman-apb3-test will kick off
    a camera capture and grab as much data as comes (the correct number of
    bytes is received).
    [TOPLEVEL.sdf]
2013-03-20 pretty sure that insight-serv.c is correct now
    it's almost complete, but a busy flag check is needed before starting an
    image capture (but that feature is currently absent from the verilog
    anyway). pretty sure this is correct now with malloc to allocate the
    buffer.
    [stonyman_apb3.v]
2013-03-22 fixed FIFO logic in stonyman driver APB3 wrapper
    there is also some general cleanup of that code. This verilog works as
    long as the application takes care to throttle itself. There is no busy
    flag in the stonyman driver to tell an application not to start a new
    conversion (and attempting to do so will cause bad things to happen).
    [stonyman_apb3.v]
2013-03-22 checking in libero files which go with the fixes
    not entirely sure what changed
    [TOPLEVEL.sdf, TOPLEVEL_ba.sdf, verilog.psm]
2013-03-22 added glassescapwebsock
    for capturing data over a web socket (ostensibly HTTP) from the
    SmartFusion with a Stonyman camera attached.
2013-03-22 updated insight-serv to use a mask
    it's currently using the nomask mask, but the feature is added. Now I
    need to compute a calibration mask for the camera I am using (#12). It
    should be noted that the Makefile is rather brittle in it's support
    (it uses a relative path within the repo which could change)
2013-03-22 deleted the calibrationcalculation symlink
    I will replace it with a directory in the next commit
2013-03-25 insight-serv uses mask for cam12
    it is appended with _sf because it is for the smartfusion (it could be
    different than computed with the teensy, but it's not likely to be THAT
    different as long as the voltages are similar and the camera has the
    same settings.
    there are actually two masks, a primary and an alternate, something I
    haven't done for other cameras.
2013-03-26 added support for the busy flag and updated timings
    added support for the busy flag with the stonyman driver. also updated
    timings to be more aggressive (to get a slightly higher framerate).
    This pushes 15fps!
    Pulsing INPHI is still set to the conservative value of 1us raised and
    1us lowered before capture (it should be noted that 800ns for each
    worked with no noticeable degradation)
2013-03-26 checking in the rest of the libero files
    the TOPLEVEL.pdc (I/O constraints) file was updated also, so it is
    synchronized
    [TOPLEVEL.sdf]
2013-03-27 updated the camera to used 5v0
    it now runs at 25FPS. it works, but there is some contrast problem. no
    mask is being used.
    [stonyman.v, stonyman_apb3.v]
2013-03-27 checked in libero changes
    no I/O constraint changes, and the exported pdc file remains
    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
    [TOPLEVEL.sdf]
2013-03-30 doubled FIFO macro size in libero
    from 4096 to 8192
    [TOPLEVEL.sdf]
2013-05-07 added the start of my senseye-insight PCB work
    it will include the next generation PCB. for now it is merely the small
    ADC boards for attaching to the Stonyman breakout boards.
    [stonyman-breakout-adc.sch]
2013-05-07 finished routing the ADC connector boards
    it seems to have passed the "ERC" check, but I didn't do a DRC. I
    haven't verified that it is the correct size yet. And, I might change
    some of the routing
    [stonyman-breakout-adc.brd, stonyman-breakout-adc.sch]
2013-05-07 better isolation of the SPI lines and GND
    [stonyman-breakout-adc.brd]
2013-05-08 pretty sure this is finished but needs to pass DRC
    [stonyman-breakout-adc.brd]
2013-05-08 added one more extra piece of GND routing
    [stonyman-breakout-adc.brd]
2013-05-08 made the board even tighter
    [stonyman-breakout-adc.brd]
2013-05-08 fixed almost all the DRC errors
    most were related to components and traces being too close to the board
    edge. there are still some keepout errors (with 0603 caps which I won't
    fix), and the analog line is justg a little too close to the headers
    [stonyman-breakout-adc.brd]
2013-05-08 fixed all DRC errors (including the 0603 caps)
    [stonyman-breakout-adc.brd]
2013-05-08 added my name, date and comment text
    [stonyman-breakout-adc.brd]
2013-05-08 fixed the text so that its silkscreen
    the last revision was actually on the top layer!
    [stonyman-breakout-adc.brd]
2013-05-08 added silkscreen text for all new inputs
    SCLK, MISO, CS and VADC
    [stonyman-breakout-adc.brd]
2013-05-08 added the gerber files
    [stonyman-breakout-adc.drl]
2013-05-08 regenerated the gerbers, but used the proper file
    this time it was a 2-layer as expected
    [stonyman-breakout-adc.drl]
2013-05-08 removed all the stuff we're not using from board
    The fuel gauge IC, the crummy camera JST connectors, everything
    [main.brd, main.sch]
2013-05-09 finished re-routing the board
    removed the stuff that wasn't used, fixing the bluetooth module's
    footprint and routing RTS and CTS.
    [main.brd, main.sch]
2013-05-09 updated the gerber files for the new board.
2013-05-09 no idea what changed in main.brd
    [main.brd]
2013-05-09 removed something from board and fixed text
    removed the thing that justin previously used to panelize the InSight
    board.
    [main.brd]
2013-05-23 fixed stonyman.v to use correct init vals
    it was hardcoded to use the 3V3 values, but I fixed it.
    [stonyman.v]
2013-05-24 updated stonyman.v to include settling delay
    there was only settling delay (of 1us) when the preamp was used before.
    Now, the (conservative) 1us settling delay applies to with and without
    the preamp. this value ought to be tweaked later to increase
    performance.
    [TOPLEVEL.sdf]
2013-05-28 added two 3.3V masks for camera 3
    computed with the teensy platform, not the smartfusion platform
2013-06-18 smartfusion 3 cameras code (only one camera works)
    added the code for the smartfusion platform to control and capture from
    3 cameras simultaneously, however, due to the size of the FIFOs, only
    one can be reliably used at once. the insight-serv code merely
    duplicates the first camera's output twice.
2013-06-26 added vfork capability to insight-serv
    but the software still uses the frontend to do everything. The software
    captures two cameras, but only sends one (three times). This is pretty
    stupid lol.
2013-06-26 added support for 2 cameras to triple...
    now it supports either 2 or 3 cameras (adding support for just 1 would
    be easy enough, but I haven't). also updated makeall.sh with the new
    name
2013-06-26 does two seperate cameras now
    but for some reason, it's not working. it does NOT. it appears to be a
    problem with the linux code, however.
2013-07-09 added fix to adc081s101 driver (init code)
    added a fix to the ADC081S101 driver which puts the module into a
    sensible state upon startup. it's unclear why this worked before (!)
2013-07-09 updated libero project to run APB at 40MHz
    double the speed of previously (20MHz). The clock subsystem still runs
    at 20MHz (including most of the stonyman logic in stonyman.v)
    [TOPLEVEL_ba.sdf, verilog.psm]
2013-07-24 added the start of my stonyman driver LKM code
2013-07-29 added read in LKM and insight-serv uses LKM
    added the read function in the stonyman driver LKM (stonyman.h/c).
    insight-serv now uses ioctl to start capture and reads from the device
    file (/dev/stonymanX).
    THERE IS NO CONCURRENCY PROTECTION. The LKM will almost certainly find
    an inconsistent state after a short time running this.
    Also, unfortunately, I've changed insight-serv.c to stream data in a
    "comet" like format, meaning that there is no way to close the socket
    connection and data just streams forever!
    [stonyman.c, stonyman.h]
2013-07-30 added spinlocks to the stonyman driver LKM
    spinlocks were added in stonyman.c to protect some of the shared image
    buffer metadata (shared between stonyman_read and stonyman_interrupt).
    the code is still pretty inefficient and only supports one camera.
2013-07-31 added seperate irq for capture finish
    updated libero project as well as the stonyman driver LKM to support
    this change. also fixed a bug in stonyman.v wherein the bit twiddling
    times were too long (due to wrong constants being used).
    [_vhdl.psm, body.psm, rtl.psm, verilog.psm]
2013-08-02 added Stonyman part to senseye eagle library
    Also, somehow, the changes to the ST SPBT2632 and the added TI
    ADC081S101 part were lost from the lbr file. I added those back in
    (although, I manually re-did the SPBT2632 change, so it is not the same
    as the Insight V1.1 board I ran)
2013-08-12 created an imager board with an ADC
    [stonyman-imager-board.brd, stonyman-imager-board.sch]
2013-08-12 created tiny imager adc board
    started over with a new board for the stonyman imager and ADC (same
    schematic). It is completely routed and passes the DRC with the
    Sunstone 2 layer DRU file. It still needs drill holes for the lens
    mount, and silkscreen.
    [stonyman-imager-board.brd, stonyman-imager-board.sch]
2013-08-13 moved two caps to make bottom ground plane connect
    [stonyman-imager-board.brd]
2013-08-13 rounded board inner corners with miter tool
    [stonyman-imager-board.brd]
2013-08-13 added labels to header and caps and resistor
    updated the SensEye Eagle library to have prefixes for parts. there
    might be other changes to the LBR file which I forgot to commit
    previously
    [stonyman-imager-board.brd, stonyman-imager-board.sch]
2013-08-13 added text to stonyman board. added mount holes
    [stonyman-imager-board.brd]
2013-08-14 fixed DRC errors with silkscreen on back
    [stonyman-imager-board.brd]
2013-08-14 moved lens mount holes into near perfect spots
    just copied CentEye's spacing
    [stonyman-imager-board.brd]
2013-08-14 updated senseye library to fix SOT23-6 tPlace
    things on tPlace were overlapping with the stop layer, which fails the
    DRC
    [stonyman-imager-board.brd, stonyman-imager-board.sch]
2013-08-14 updated 2X6/0.05IN headers to have no silkscreen
    [stonyman-imager-board.brd, stonyman-imager-board.sch]
2013-08-14 almost completed silkscreen labels
    [stonyman-imager-board.brd]
2013-08-14 added the small cap between ANALOG and GND
    per Geof's suggestion. It's an optional cap.
    [stonyman-imager-board.brd, stonyman-imager-board.sch]
2013-08-14 added stopmask to wirebond pads in stonyman part
    [stonyman-imager-board.brd, stonyman-imager-board.sch]
2013-08-14 pretty sure I've finished the board
    [stonyman-imager-board.brd, stonyman-imager-board.sch]
2013-08-15 removed one final airwire in imager-adc board
    it was on the OE line's wirebond pad. Apparently, I hadn't quite
    connected the routing to Eagle's liking, but it's fixed now.
    [stonyman-imager-board.brd, stonyman-imager-board.sch]
2013-08-15 added the PDF of the imager board design
2013-08-15 ADC completes faster, added stonyman.v features
    updated the ADC controller to trigger complete faster (as soon as the
    correct number of bits have been read), while still not raising the CS
    line or allowing a conversion any earlier. This has made the overall
    image capture quite a bit faster (from ~29 Hz up to ~ 32.5 Hz).
    added features to the stonyman.v controller to allow for a different
    input pixel size and output pixel size with minimal processing
    (subtracting a fixed value and then mapping the bottom bits to the
    output pixel). It is functionally the same right now.
    [TOPLEVEL.v, coreparameters.v, imaging.v, stonyman.v, testbench.v]
2013-08-15 changed senseye-serv output while sending frames
    there is only a frame complete message now, which allows it to take less
    time during frame transmission.
2013-08-15 added support for partial image reads in LKM
    the stonyman LKM driver now allows the application to read any data
    available even if less than a whole image is available.
2013-08-15 very minor update to senseye-serv.c
    replaced raw stonyman driver device filename string with the
    preprocessor define
2013-08-15 added "auto-delay" mode to stonyman driver
    the stonyman driver will now optionally stall when there are no free
    frame buffers in the ring buffer. however, it requires recompilation to
    enable
    [stonyman.c, stonyman.h]
2013-08-16 added GND trace between the caps and edge of board
    The polygone for the GND plane didn't fill this in, but there was room,
    and I think it belonged there
    [stonyman-imager-board.brd]
2013-08-19 started control groups support in stonyman_apb3.v
    control groups will be groups of cameras which can be controlled
    together. The interface has been created for 4 control groups of 4
    cameras each. Each control group used requires a stonyman controller
    instantiation (stonyman.v) and each camera used requires an ADC
    controller instantiation (adcxx1s101.v) and a pixel FIFO instantiation.
    Currently, the backend is the same, so only 4 cameras in one control
    group are currently supported (using the interface for the other 3
    control groups will not work, as the signals are not backed by any logic
    yet).
    [TOPLEVEL.v, coreparameters.v, imaging.v, stonyman_apb3.v, testbench.v]
2013-08-19 updated board dimensions to accomodate lens mount
    Added extra width on the tabs to give more space for the mounting
    holes. also moved everything above the 0.05 in headers up just a little
    bit to give more space between headers and the lens mount.
    [stonyman-imager-board.brd, stonyman-imager-board.sch]
2013-08-20 added tDocu layer around the 2x6 0.05in headers
    this is for the NO_SILK variant, and it matches the silkscreen layer of
    the variant with a silkscreen layer. this should have been committed
    with the last commit of the board file.
2013-08-20 added more space between headers and lens mount
    now the tDocu layers of the headers and the lens mount do not overlap at
    all.
    [stonyman-imager-board.brd]
2013-08-20 changed DRC rules to tent vias
    min via width for adding stop mask is 16mil (my vias are 14mil)
    [stonyman-imager-board.brd]
2013-08-20 added my simple create-pdf.sh script
    for creating the PDF for the stonyman-imager-board. also added
    .gitignore to ignore intermediate files.
2013-08-21 renamed adc081s101.v to adcxx1s101.v, pt 2
    updated libero to handle this new file/module name. also, made minimal
    modifications to adcxx1s101.v (just the basics)
    [TOPLEVEL.sdf]
2013-08-21 ADCXX1S101 controller now supports 8,10 or 12 bits
    also made the code more parameterized and added some comments.
    currently, it is emulating an 8-bit ADC with a 12-bit ADC by using the
    lower 8 bits of the 12-bit ADC, so it has a FIXME comment, but it should
    be clear how it ought to be used correctly
    [adcxx1s101.v]
2013-08-21 renamed libero project from insight to senseye
    this has been a long time coming
    [TOPLEVEL.sdf, TOPLEVEL_ba.sdf, _vhdl.psm, body.psm, rtl.psm, verilog.psm]
2013-08-22 nonfunc. updated stonyman peripheral address space
    with support for selecting control group and camera within a control
    group. it is still not entirely implemented, and this change is
    nonfunctional.
2013-08-22 stonyman_apb3 supports indepenedent control groups
    support for independent control groups in stonyman_apb3 is implemented
    now. it supports up to 4 control groups of up to 4 cameras each.
2013-08-22 updated commend for v0.06 of stonyman driver
2013-08-22 updated libero project for 2 independent cams
    the second camera is not wired up to anything outside of the imaging
    subsystem smartdesign
2013-08-22 LKM driver multi-cam finish interrupts support
    starting multi-cam support by supporting capture done interrupts for
    every camera. this means that each camera is expected to be part of its
    own control group (simultaneous capture of multiple cameras will not be
    supported in the driver for now). each camera now has two GPIO
    interrupts, a capture done interrupt and a high water interrupt. there
    is also a lot of cleanup in the GPIO defines.
2013-08-23 fixed start capture bug in stonyman_apb3.v
    [stonyman_apb3.v]
2013-08-23 stonyman driver LKM supports multiple cameras
    the framerate has taken a hit, because each camera is checked in each
    interrupt, regardless of which triggered the interrupt. this needs
    fixed.
    also, it does not currently support simultaneous capture of multiple
    cameras within a control group (each camera requires its own control
    group).
    [stonyman.c, stonyman.h]
2013-08-23 stonyman_interrupt uses irq to determine camidx
    which gives a slight improvement in framerate
2013-08-27 added second cam test points in libero
    added test points for cam1 (second camera) in imaging subsystem
    smartdesign.
2013-08-28 stonyman_interrupt calculates camidx smarter
    it is now a mathematical operation instead of a loop. it should be
    faster in theory, at least for higher camera indices, because it is now
    a set number of instructions (instead of a loop with a break statement).
2013-09-05 some odd fix with the busy signal in stonyman.v
    I don't totally understand why it didn't work before, but it works now.
    [stonyman.v]
2013-09-05 all libero changes related to previous check-in
    all libero changes related to the previous check-in (the check in
    regarding the BUSY/STARTCAP signal interchange problem)
    [MSS_CORE2.v, TOPLEVEL.v, coreparameters.v, testbench.v]
2013-09-09 fixed a hard to spot bug in tripledisplay...
    The bug confused FRAME_X_Y with FRAME_LEN in unpacking the stream image
    data into the OpenCV image data formats. It was probably a hold-over
    from the dual scanline format from the InSight/SensEye v1 and earlier
    glasses.
2013-09-09 updated default IP address for web capture device
2013-09-09 senseye-serv now supports multiple cameras (2)
    senseye-serv supports multiple cameras using the LKM device driver
    interface (using the /dev/stonymanX device file for ioctl and reading)
2013-09-09 changed "or equals" to "equals" in stonyman
    for some reason, this was causing erroneous camera triggers in the
    Stonyman driver LKM.
2013-09-30 added single camera support to triple...
    added single camera support to tripledisplayandsave utility. it
    previously supported 2 and 3 cameras only
2013-10-03 deleted libero project 'capture'
    [_vhdl.psm, body.psm, mss_capture.sdf, rtl.psm, verilog.psm]
2013-10-24 fixed ADC pin swap bug in stonyman-imager-board
    I had switched pin 1 with pin 3, the positive supply and analog in pins
    respectively, due to their stupid names. I have updated the part so
    that the names are very clear now, and also fixed the schematic and
    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
    [stonyman-imager-board.brd, stonyman-imager-board.sch]
2013-10-24 deleted stonyman-breakout-adc
    this was never built and never will be
    [stonyman-breakout-adc.brd, stonyman-breakout-adc.sch]
2013-10-24 activated useful top layers: stonyman-imager-board
    mostly only bottom layers were active, but now, top layers are too
    [stonyman-imager-board.brd]
2013-10-28 added larger via with soldermask for ANALOG
    this is a more accessable test point for the ANALOG signal. It doesn't
    alter the board design much, it's just a tad bigger. Signals were
    re-routed around it.
    Also expanded the ground planes to fill in the area under the ADC.
    [stonyman-imager-board.brd]
2013-10-28 expanded distance between headers and lens mount
    in the board file for the stonyman-imager-board. Also, updated the date
    on the silkscreen to today's date.
    [stonyman-imager-board.brd]
2013-10-28 removed the gerber files for the old breakout adc
    [stonyman-breakout-adc.drl]
2013-10-28 updated silkscreens on stonyman imager board
    now the VADC/VCC 0 Ohm pad makes more sense
    [stonyman-imager-board.brd, stonyman-imager-board.sch]
2013-10-28 fixed silkscreen for centering stonyman pixel area
    the crosshairs silkscreen for the stonyman die are now targetting the
    center of the pixel plane rather than the center of the stonyman die
    [stonyman-imager-board.brd, stonyman-imager-board.sch]
2013-10-28 created stonyman-imager-board.cam
    forked 2LPlus-Sunstone.cam to create stonyman-imager-board.cam. The
    stonyman-imager-board.cam reverses top and bottom when generating gerber
    files.
2013-10-28 generated gerbers for stonyman-imager-board
2013-10-31 updated stonyman-imager-board with DIGIKEY info
    now, a bom can be created by running "bom.ulp" from Eagle and checking
    the box to also include attributes. all parts in this board now have
    DIGIKEY attributes.
    [stonyman-imager-board.brd, stonyman-imager-board.sch]
2013-10-31 created BOM for stonyman-imager-board
    [stonyman-imager-board_bom.csv, stonyman-imager-board_bom.xlsx]
2013-10-31 renamed stonyman-imager-board to imager-adc, pt 1
    files have been renamed, but no files have changed. files will change
    in pt 2 of this commit.
    [imager-adc.brd, imager-adc.sch, imager-adc_bom.csv, imager-adc_bom.xlsx]
2013-10-31 renamed stonyman-imager-board to imager-adc, pt 2
    actually changing files now. reopened and closed eagle.epf. updated
    doc/.gitignore and doc/create-pdf.sh. also, updated 2 gerber files by
    hand.
2013-10-31 added the lab frame to the schematic file.
    [imager-adc.sch]
2013-10-31 added revision silk screen to imager-adc
    it's a letter (in this case, b) in a circle
    [imager-adc.brd]
2013-10-31 updated gerbers and documentation pdf
2013-10-31 updated board layout to bridge grounds beneath ADC
    which is supposed to be good practice in mixed digital/analog design
    [imager-adc.brd]
2013-10-31 updated gerbers and board document
2014-01-16 Added the SensEye wirebonding document
2015-01-20 Moved SensEye v1 Android frontend to new location.
    Moved the Android code to its new location in the reorganization,
    /v1/sw/capture_frontend/android. The code is unchanged and is still
    whatever Joe put in there. The android frontend does not implement the
    SensEye data processing protocol.
    [proguard.cfg]
2015-01-20 Moved the v1 Eagle files to new location.
    Moved the v1 Eagle files (the Teensy shield) to the new location in the
    reorganization, /v1/hw/eagle_pcb/teensy-shield.
    [main-old.brd, main-stencil.dxf, main.brd, main.dxf, main.sch, panel.brd]
2015-01-20 Moved the v2 eagle files and wirebonding doc.
    Moved the v2 eagle files and wirebonding doc to new location for
    reorganization. The new location is /v2/hw/imager_adc_board.
    [imager-adc.brd, imager-adc.sch, imager-adc_bom.csv, imager-adc_bom.xlsx]
2015-01-20 Slight change in organization in /v1/hw
    Created a directory specifically to hold the Eagle files within the
    eagle_pcb directory.
    [imager-adc.brd, imager-adc.sch, imager-adc_bom.csv, imager-adc_bom.xlsx]
2015-01-20 Moved SmartFusion Libero project to new location.
    Moved SmartFusion Libero project to new location for reorganization.
    The new location is /v2/sw/embedded/smartfusion_libero/senseye.
    [TOPLEVEL_ba.sdf, _vhdl.psm, body.psm, rtl.psm, verilog.psm]
2015-01-20 Moved Stonyman LKM driver to new location.
    Moved the Stonyman drive (LKM) to new location for reorganization. The
    new location is /v2/sw/embedded/stonyman_drv.
2015-02-06 Another reorganization of the source.
    Another reorganization of the source with top level hw and sw folders.
    Lets folder depth for some parts.
    [TOPLEVEL_ba.sdf, _vhdl.psm, body.psm, imager-adc.brd, imager-adc.sch, imager-adc_bom.csv, imager-adc_bom.xlsx, main-old.brd]
2015-02-06 Updated some Makefiles to reflect path changes.
    Updated the capture_replay and frontdisplayandsave Makefiles (for linux
    and OS X) to reflect the path changes. Currently, the path to
    libglasses is hardcoded.
2015-02-06 Updated glasses_util.h/c with CLI helpers.
    Created print_usage, print_help and parse_args helper functions in
    glasses_util.h/c for all the PC programs to use in a standard way
    without duplicating the code in each C file.
2015-02-15 Added gdp_read(...) prototype to glasses_proto.h.
2015-02-16 Finalized v1.00.01 of glasses_proto.h/c.
    Added missing prototype for gdp_read(...). Fixedgdp_read_frame(...) to
    return correct number of bytes in non-scanline mode.
2015-02-16 Replaced frontdisplayandsave with new tools.
    Replaced frontdisplayandsave with two utilities: glasses_display and
    glasses_record. For now, some trickery is required for using both
    utilities at the same time. Using tee to split one of the two off from
    the main chain of piping will work.
    These two new utilities support the all new glasses data protocol (GDP)
    and glasses data exchange format (GDF). These formats are effectively
    backwards compatible with all previous work. The only change to GDP
    changes the EXIT command opcode, which is not used by embedded code, and
    therefore not vital for backwards compatibility.
    Two new libglasses modules were added to support this: glasses_proto.h/c
    an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
2015-03-19 Renamed the wirebonding document (pt 1).
2015-03-19 Renamed the wirebonding document (pt 2).
2015-03-19 Reformatted wirebonding instructions to fit...
    Reformatted wirebonding instructions to fit in two pages.
2015-03-19 Added README.md for SensEye wirebonding doc.
2015-04-13 Deleted hardware_specific_variants.
    Deleted the sw/v1/embedded/hardware_specific_variants directory.
    cameracapture and dualcameracapture absorbed that functionality long
    ago.
2015-05-06 Renamed sw to software and hw to hardware.
    [TOPLEVEL_ba.sdf, _vhdl.psm, body.psm, imager-adc.brd, imager-adc.sch, imager-adc_bom.csv, imager-adc_bom.xlsx, main-old.brd]
2015-05-13 Added source documents for imager-adc.pdf.
2015-05-13 Renamed imager-adc.pdf README.md to README.
2015-05-13 Updated imager-adc.pdf README to make sense.
2015-05-13 Created a README for the Stonyman ADC board.
2015-05-13 Added a sentence to the wirebonding instructions.
    Added a sentence to the wirebonding instructions referring to the
    CentEye Stonyman breakout board instructions.
2015-05-13 Reduced unnecessary subdirectory depth.
    Removed the "imager-adc" folder from the hierarchy as it added no value.
    [imager-adc.brd, imager-adc.sch, imager-adc_bom.csv, imager-adc_bom.xlsx]
2015-05-13 Renamed eagle_pcb/doc to schematic_and_layout_pdf.
2015-05-13 Removed one statement from Imager/ADC README.
2015-05-21 More complete .gitignore for Stonyman LDM driver.
2015-05-21 Added a still frame to the README.md.
2015-05-21 Tweaked the working about battery charging.
2015-05-21 Better text surrounding assembly of v1.1 glasses.
2017-05-08 Fixed link to /hardware/v1/teensy-shield
2019-03-15 Added icon for gitlab and single frame image
